Eryk-Mozdzen/minisumo-scalak/README.md

# Autonomous minisumo robot Scalak

<p align="center">
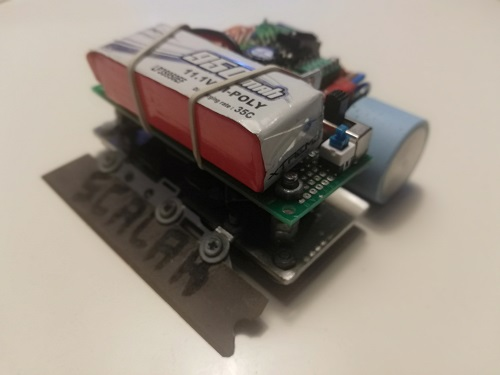
[picture p1: docs/raport/images_overall/scalak_photo1.jpg]
  
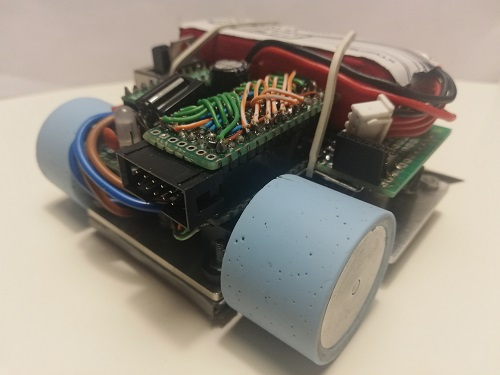
[picture p2: docs/raport/images_overall/scalak_photo2.jpg]
  
</p>

Minisumo robot "Scalak" with ATmega328p microcontroller.
