Eryk-Mozdzen/minisumo-scalak/app/Sumo Remote.png

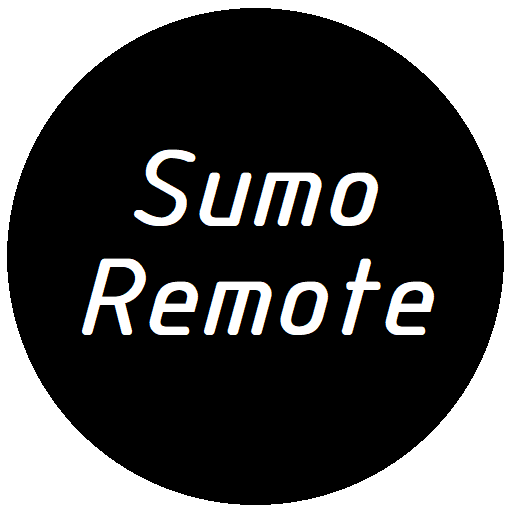
app/Sumo Remote.png
