Eryk-Mozdzen/minisumo-scalak/app/SumoMenagerLayout.png

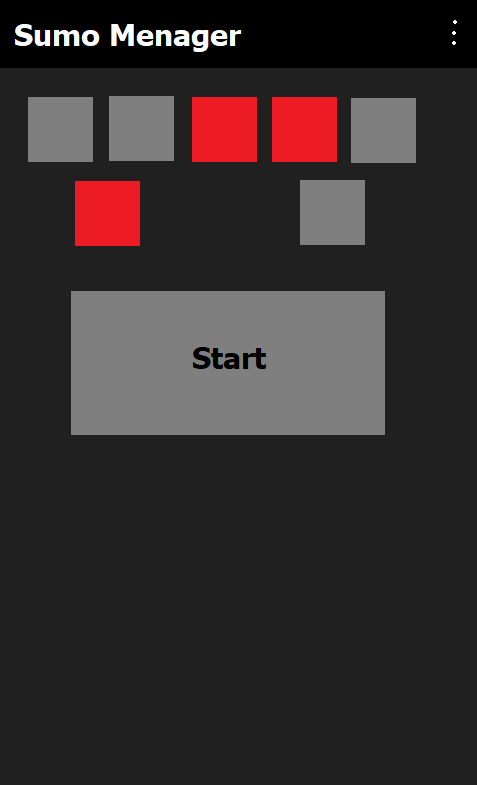
app/SumoMenagerLayout.png
