Eryk-Mozdzen/minisumo-scalak/docs/others/13.jpg

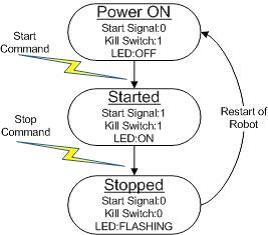
docs/others/13.jpg
