Eryk-Mozdzen/minisumo-scalak/docs/others/ListaDoMiniSumo.png

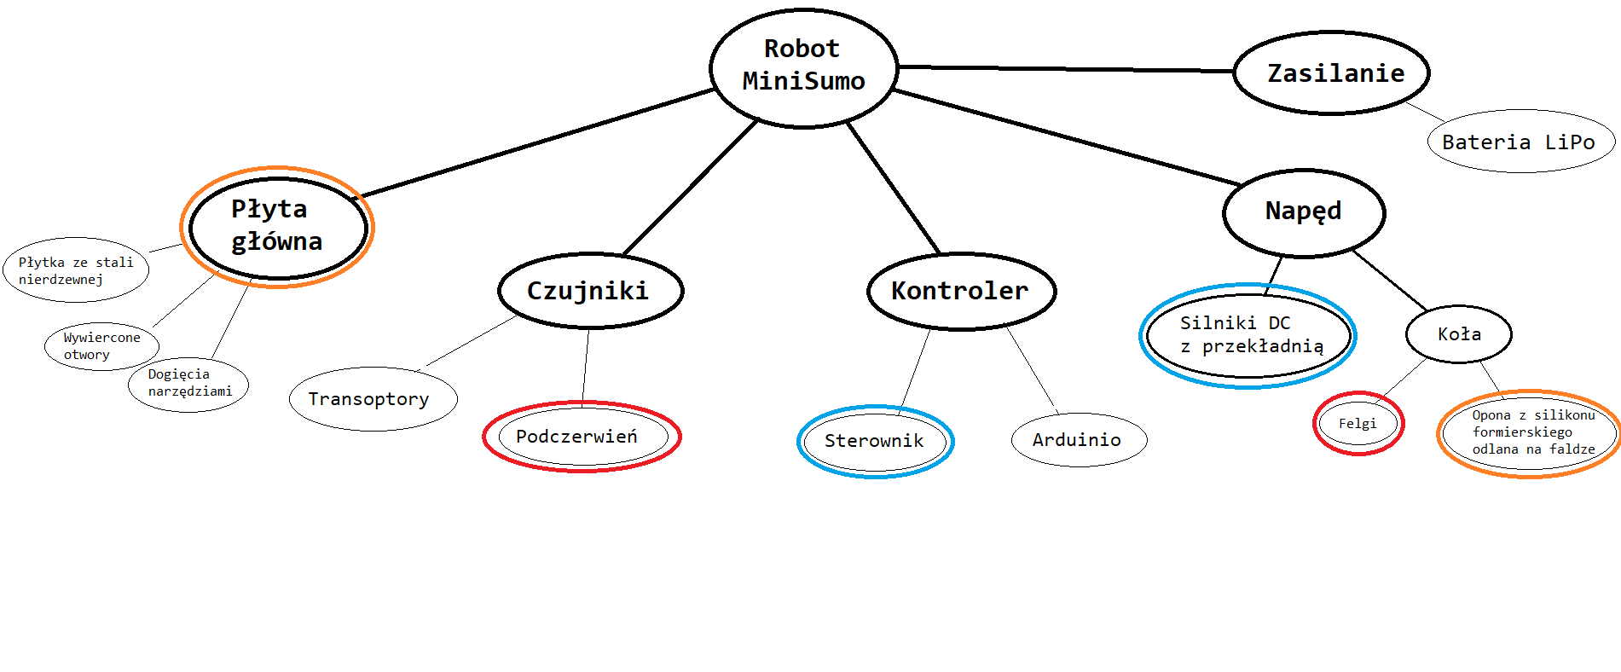
docs/others/ListaDoMiniSumo.png
