Eryk-Mozdzen/minisumo-scalak/docs/others/nazwa.png

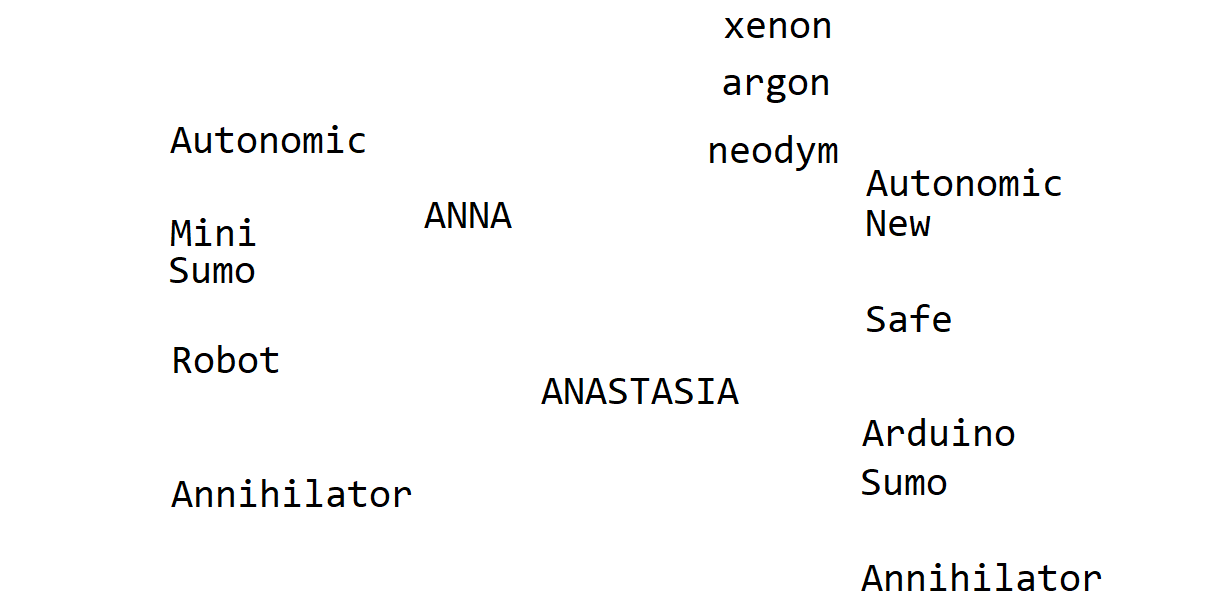
docs/others/nazwa.png
