Eryk-Mozdzen/minisumo-scalak/docs/others/pid_dla_krola.png

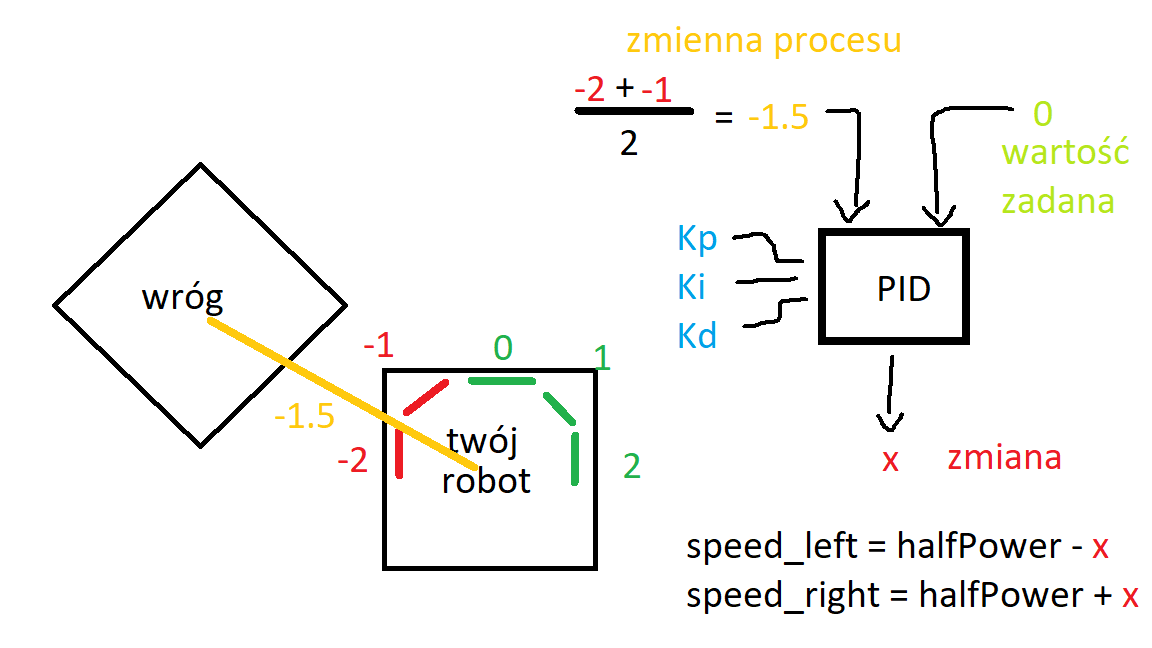
docs/others/pid_dla_krola.png
