Eryk-Mozdzen/minisumo-scalak/docs/others/Przechwytywsefsfeanie.PNG

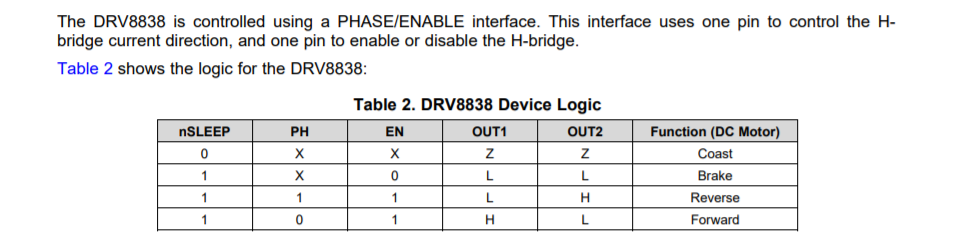
docs/others/Przechwytywsefsfeanie.PNG
