Eryk-Mozdzen/minisumo-scalak/docs/others/rc5_scheme.png

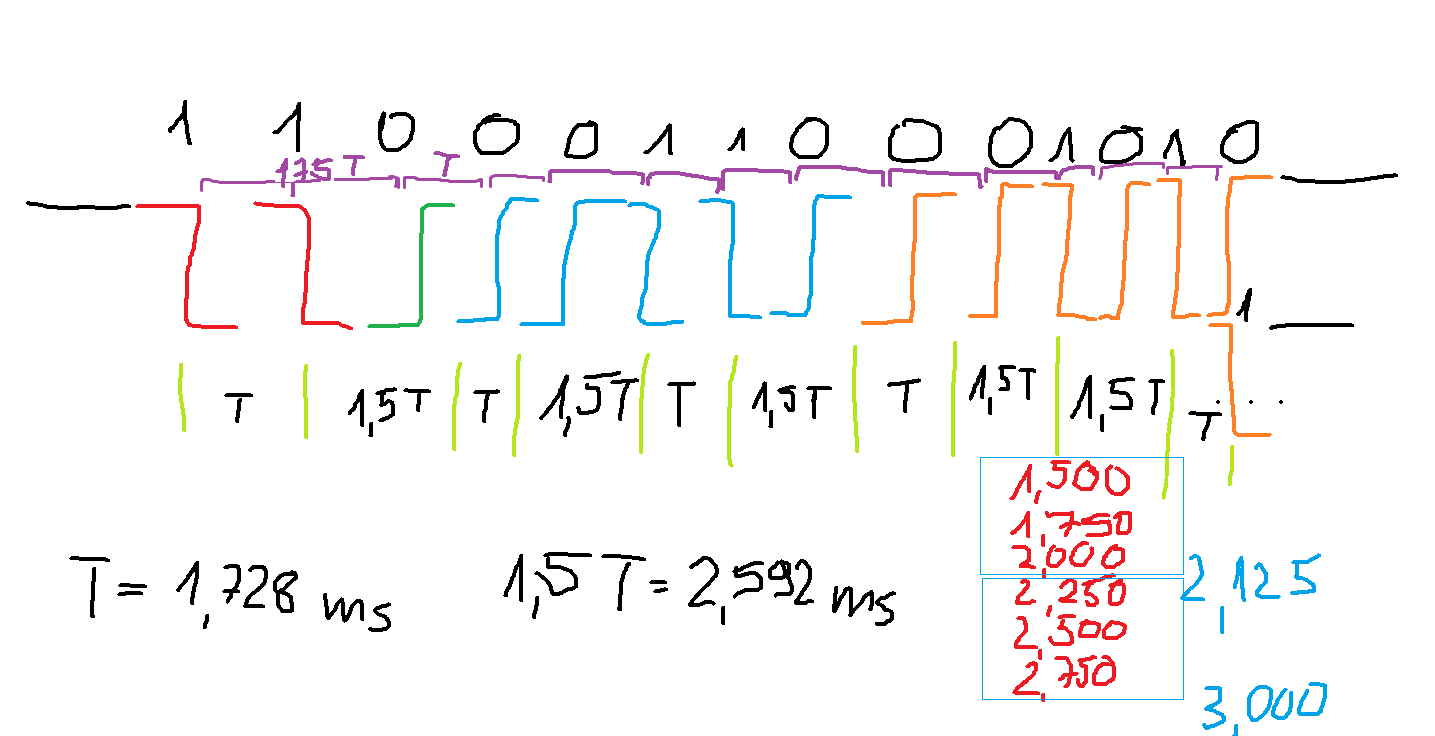
docs/others/rc5_scheme.png
