Eryk-Mozdzen/minisumo-scalak/docs/photos/82588347_592529804923607_3943885901741948928_n.jpg

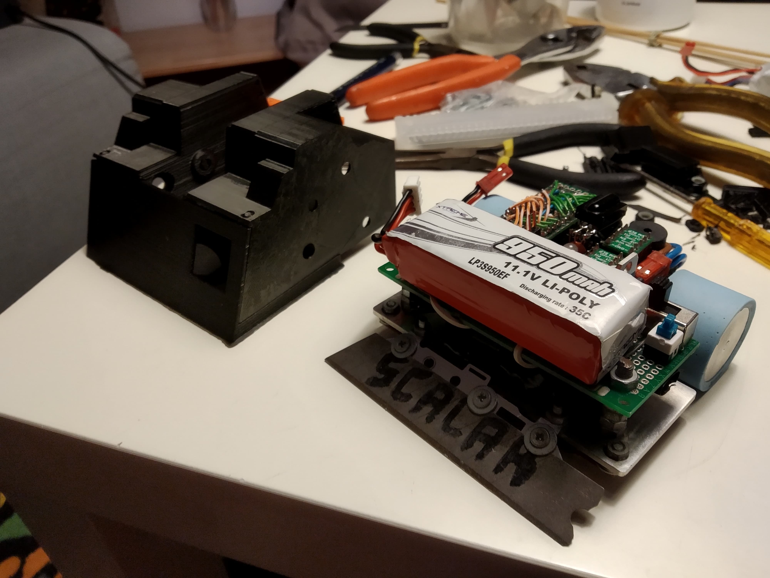
docs/photos/82588347_592529804923607_3943885901741948928_n.jpg
