Eryk-Mozdzen/minisumo-scalak/docs/photos/82605323_181935769839971_6889383114812948480_n.jpg

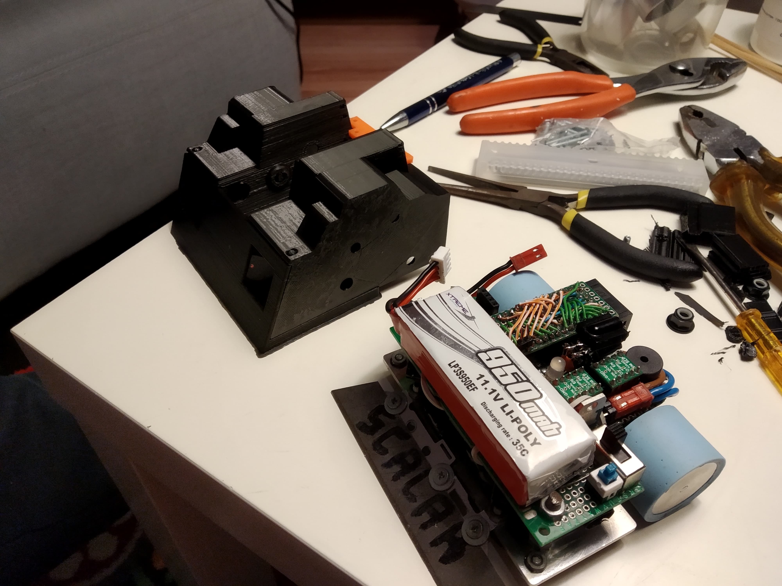
docs/photos/82605323_181935769839971_6889383114812948480_n.jpg
