Eryk-Mozdzen/minisumo-scalak/docs/photos/87043215_3062624950436579_475866983234011136_o.jpg

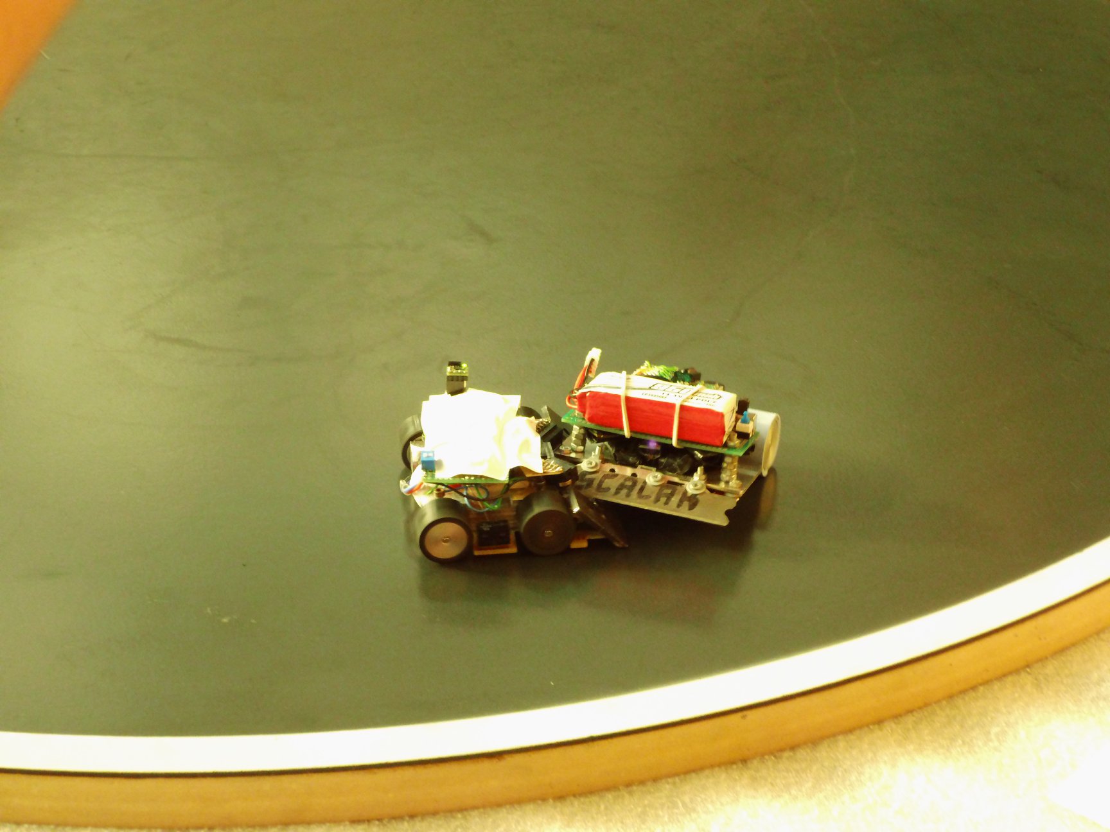
docs/photos/87043215_3062624950436579_475866983234011136_o.jpg
