Eryk-Mozdzen/minisumo-scalak/docs/photos/FB_IMG_1552458001613.jpg

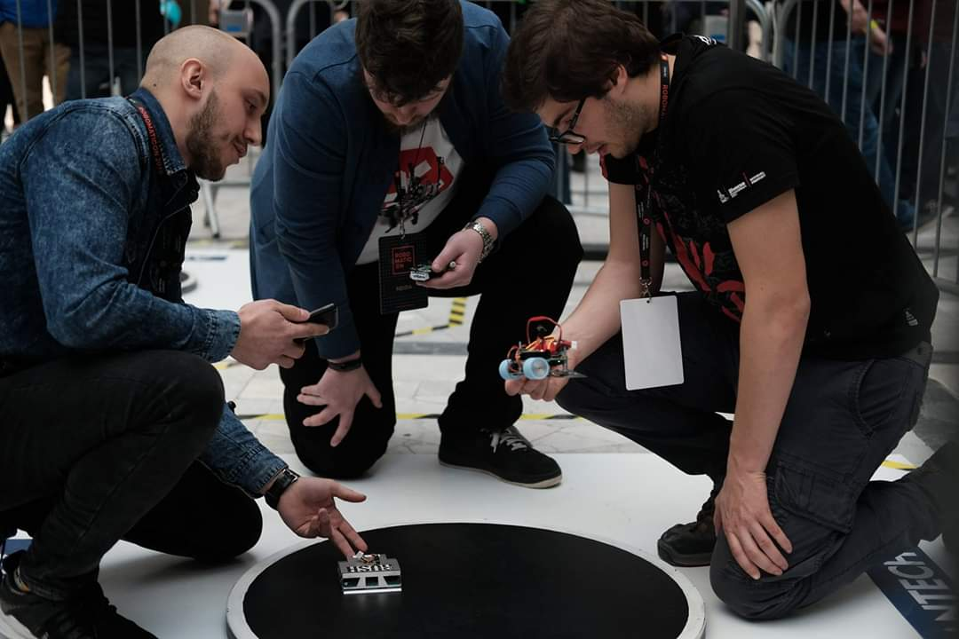
docs/photos/FB_IMG_1552458001613.jpg
