Eryk-Mozdzen/minisumo-scalak/docs/photos/FB_IMG_1580551799463.jpg

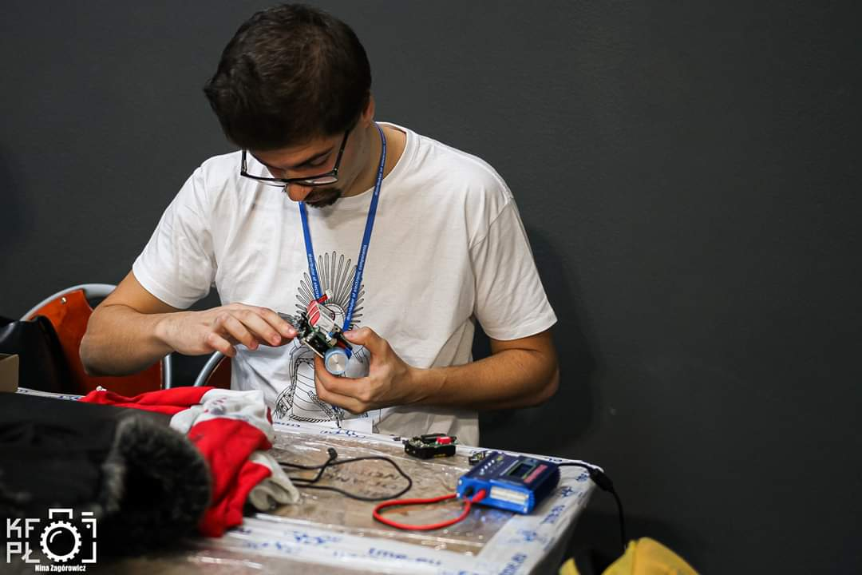
docs/photos/FB_IMG_1580551799463.jpg
