Eryk-Mozdzen/minisumo-scalak/docs/photos/IMG_20200125_100642.jpg

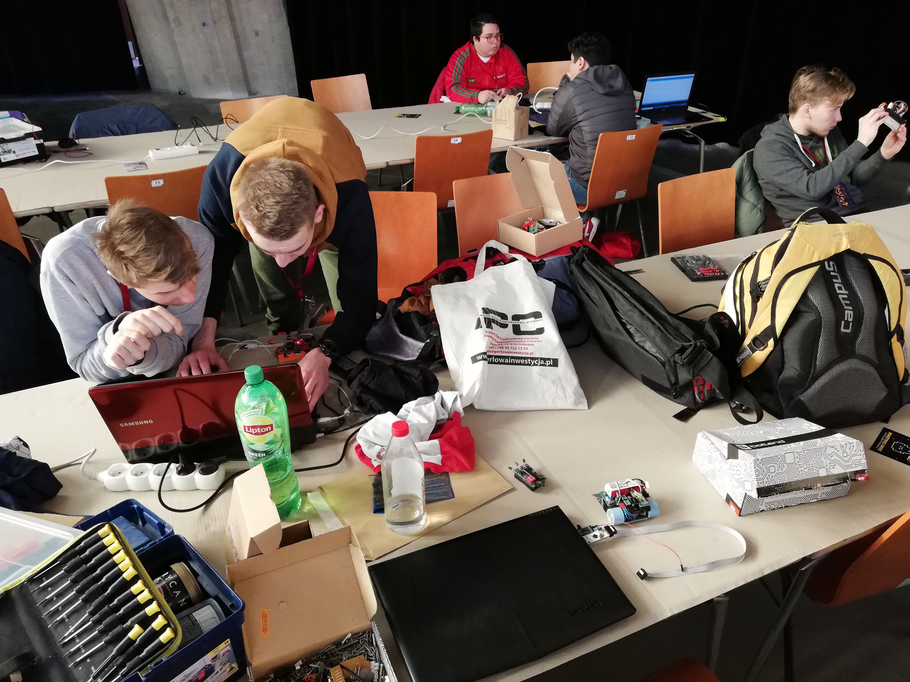
docs/photos/IMG_20200125_100642.jpg
