Eryk-Mozdzen/minisumo-scalak/docs/raport/images_mechanics/scalak_autocad_frame.png

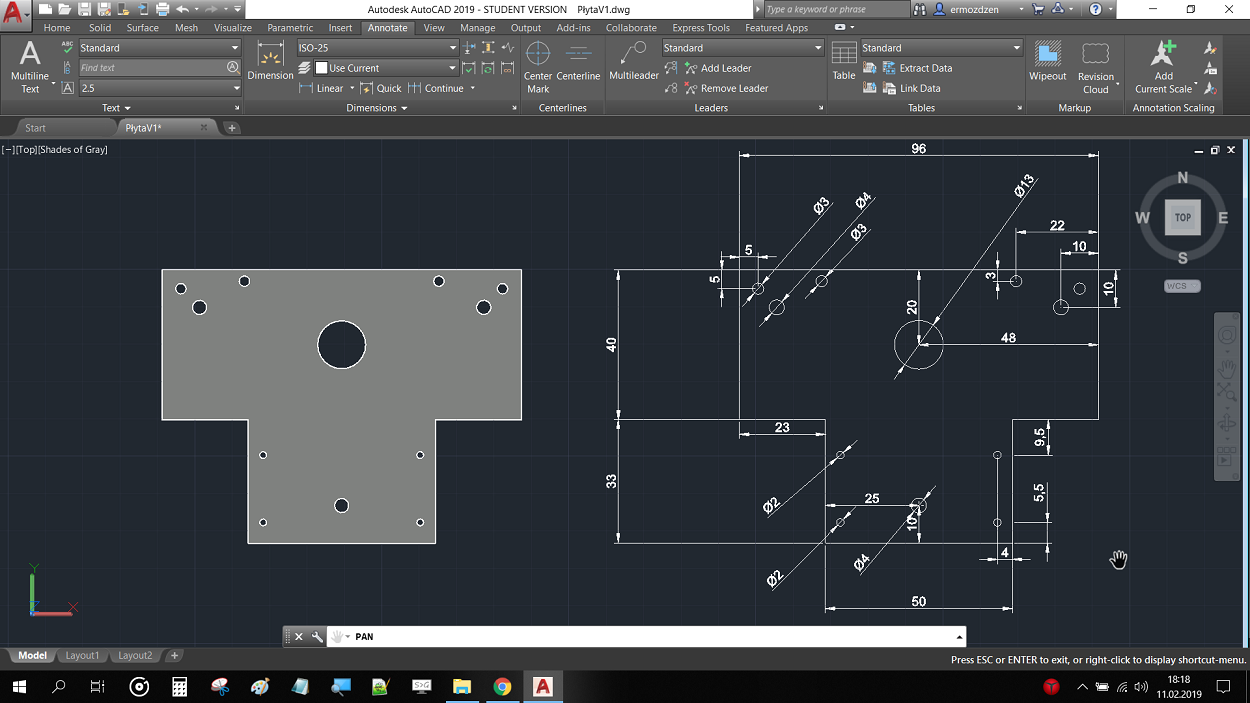
docs/raport/images_mechanics/scalak_autocad_frame.png
