Eryk-Mozdzen/minisumo-scalak/docs/raport/images_mechanics/scalak_autocad_wheel.png

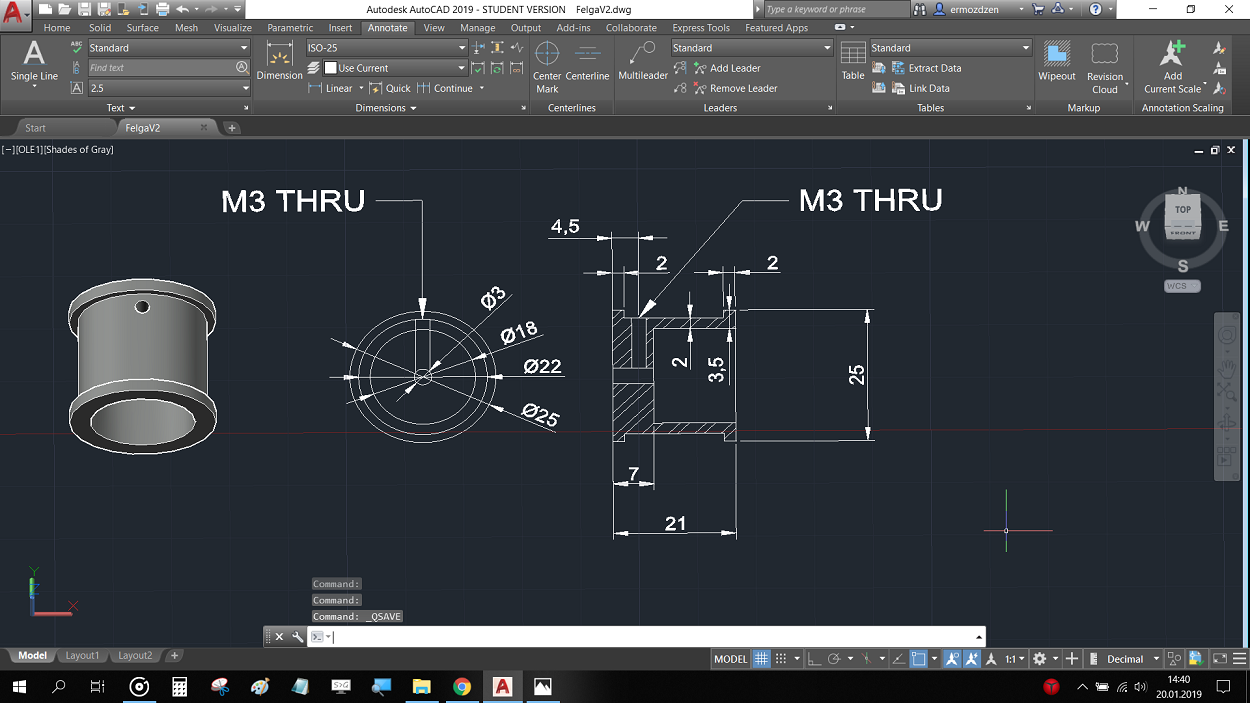
docs/raport/images_mechanics/scalak_autocad_wheel.png
