Eryk-Mozdzen/minisumo-scalak/docs/raport/images_mechanics/scalak_frame1.jpg

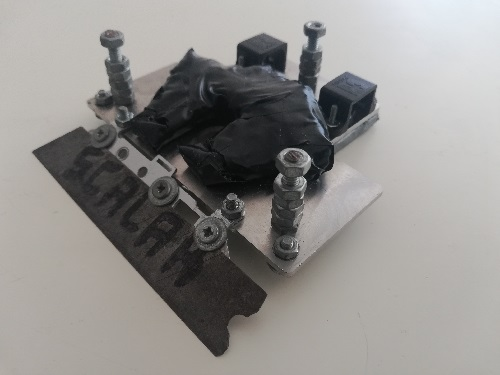
docs/raport/images_mechanics/scalak_frame1.jpg
