Eryk-Mozdzen/minisumo-scalak/docs/raport/images_mechanics/scalak_frame2.jpg

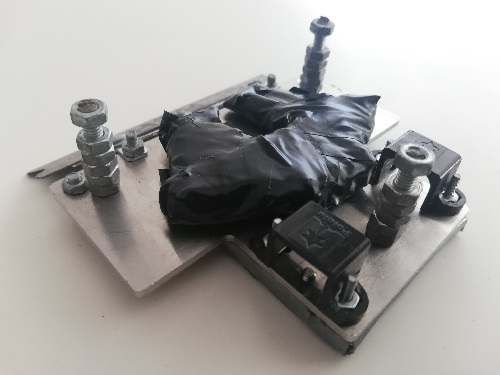
docs/raport/images_mechanics/scalak_frame2.jpg
