Eryk-Mozdzen/minisumo-scalak/docs/raport/images_mechanics/scalak_frame3.jpg

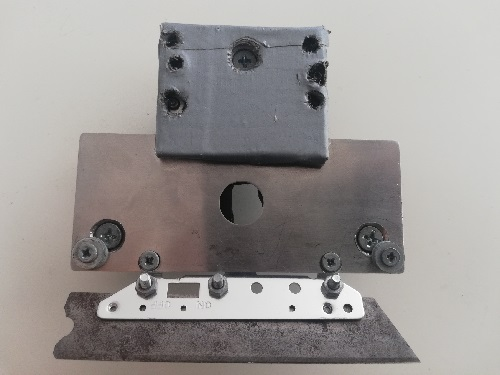
docs/raport/images_mechanics/scalak_frame3.jpg
