Eryk-Mozdzen/minisumo-scalak/docs/raport/images_mechanics/scalak_weight.jpg

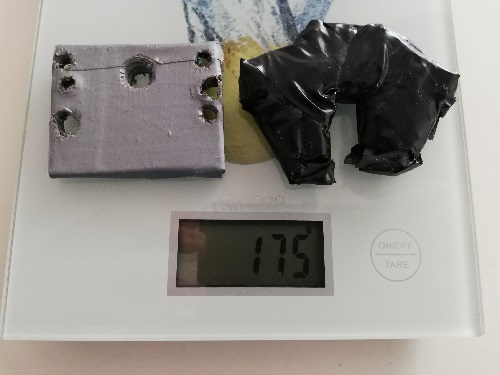
docs/raport/images_mechanics/scalak_weight.jpg
