Eryk-Mozdzen/minisumo-scalak/docs/raport/images_overall/scalak_photo_back.jpg

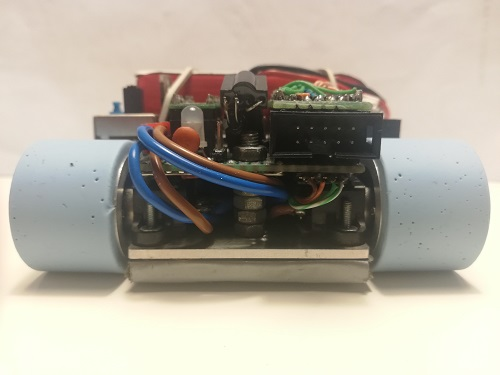
docs/raport/images_overall/scalak_photo_back.jpg
