Eryk-Mozdzen/minisumo-scalak/docs/raport/images_overall/scalak_photo_bottom.jpg

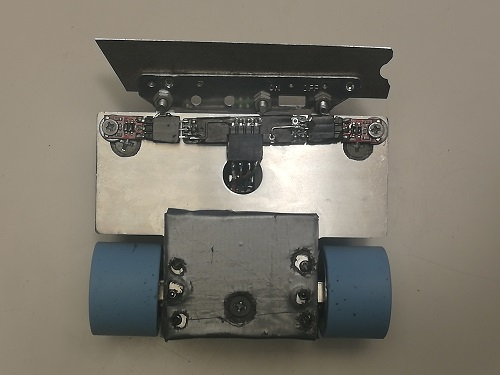
docs/raport/images_overall/scalak_photo_bottom.jpg
