Eryk-Mozdzen/minisumo-scalak/docs/raport/images_overall/scalak_photo_front.jpg

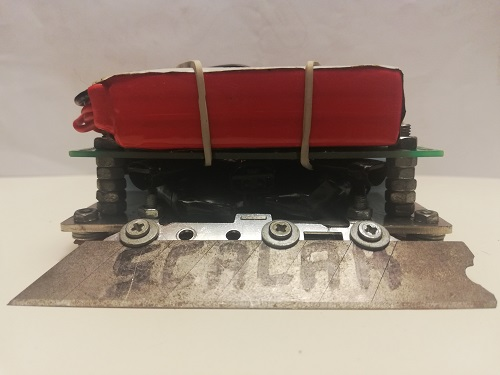
docs/raport/images_overall/scalak_photo_front.jpg
