Eryk-Mozdzen/minisumo-scalak/docs/raport/images_overall/scalak_photo_left.jpg

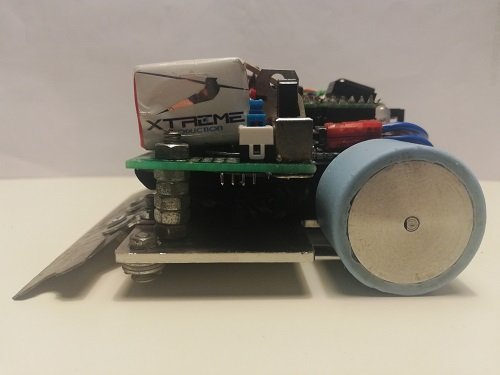
docs/raport/images_overall/scalak_photo_left.jpg
