Eryk-Mozdzen/minisumo-scalak/docs/raport/images_overall/scalak_photo_right.jpg

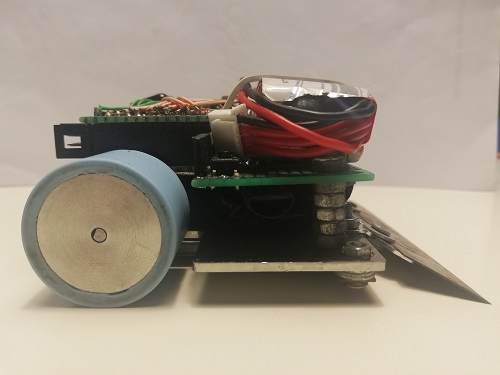
docs/raport/images_overall/scalak_photo_right.jpg
