Eryk-Mozdzen/minisumo-scalak/docs/raport/images_overall/scalak_photo_top.jpg

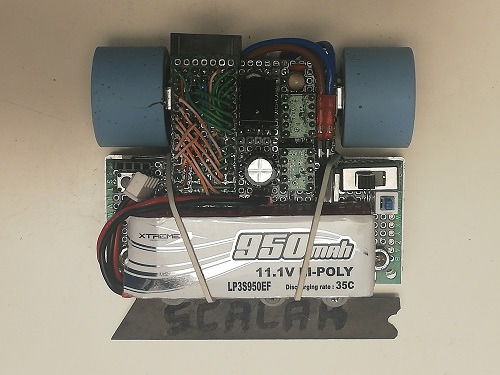
docs/raport/images_overall/scalak_photo_top.jpg
