Eryk-Mozdzen/minisumo-scalak/hardware/notes/DIY_biedaPCB2.png

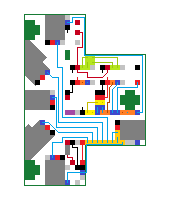
hardware/notes/DIY_biedaPCB2.png
