Eryk-Mozdzen/minisumo-scalak/hardware/notes/DIY_biedaPCB NEW — kopia.png

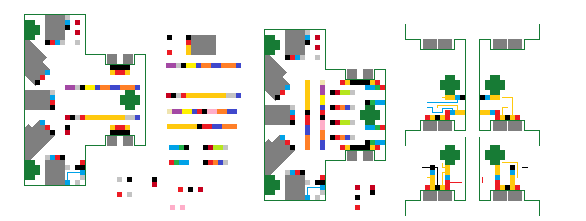
hardware/notes/DIY_biedaPCB NEW — kopia.png
