Eryk-Mozdzen/minisumo-scalak/hardware/notes/DIY_biedaPCB NEW.png

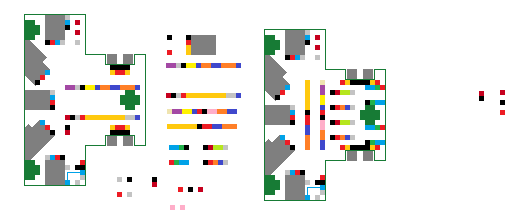
hardware/notes/DIY_biedaPCB NEW.png
