Eryk-Mozdzen/minisumo-scalak/hardware/notes/DIY_biedaPCB.png

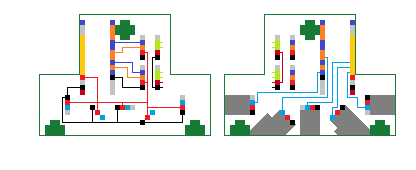
hardware/notes/DIY_biedaPCB.png
