Eryk-Mozdzen/minisumo-scalak/hardware/notes/StartModuleIR.png

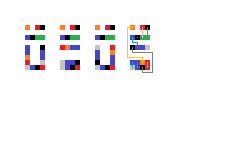
hardware/notes/StartModuleIR.png
