Eryk-Mozdzen/minisumo-scalak/hardware/notes/Zrzut ekranu (163).png

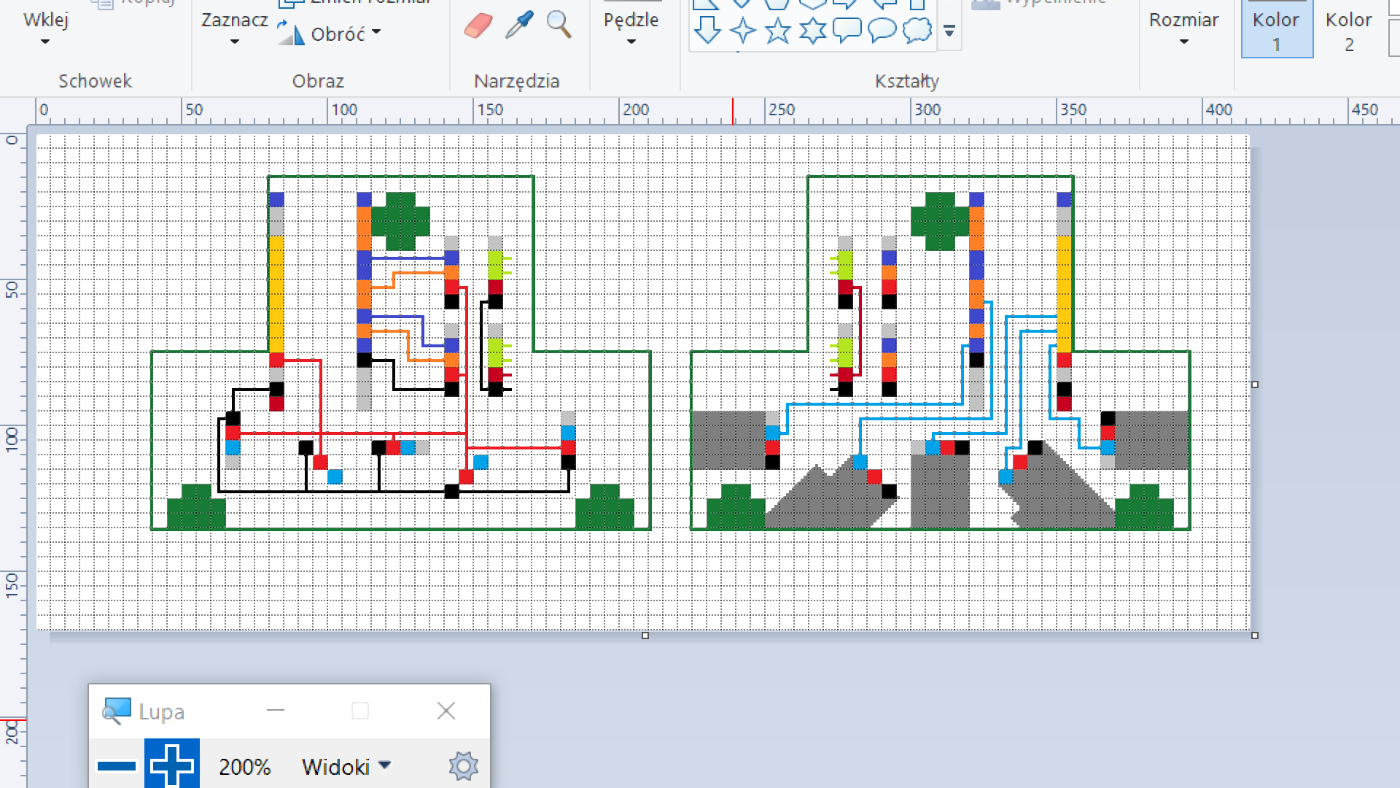
hardware/notes/Zrzut ekranu (163).png
