Eryk-Mozdzen/minisumo-scalak/hardware/pinouts/0J7398.1200.jpg

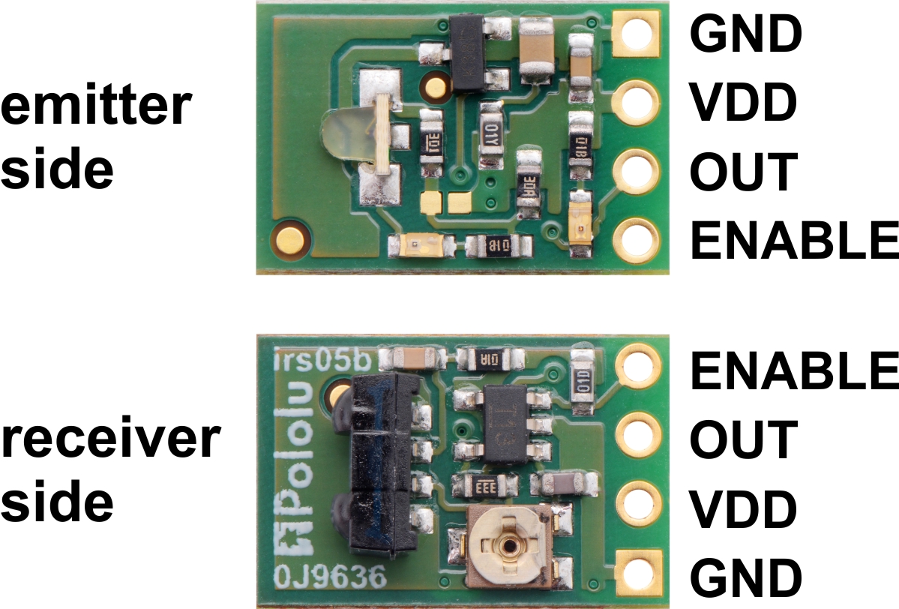
hardware/pinouts/0J7398.1200.jpg
