Eryk-Mozdzen/minisumo-scalak/hardware/pinouts/12.jpg

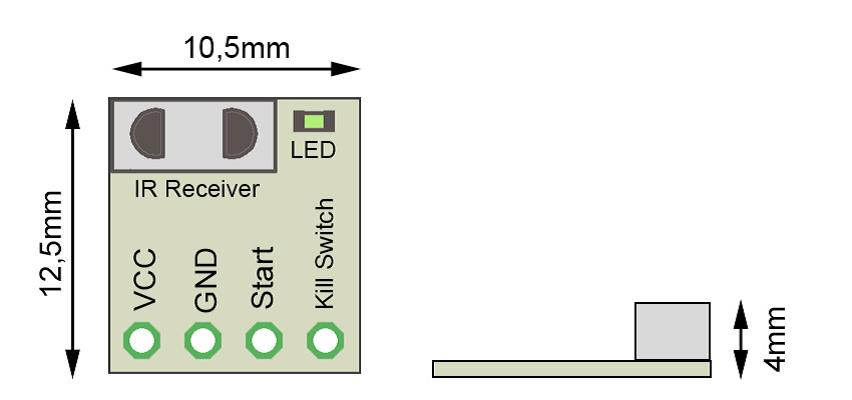
hardware/pinouts/12.jpg
