Eryk-Mozdzen/minisumo-scalak/hardware/pinouts/LM393N_pinout.PNG

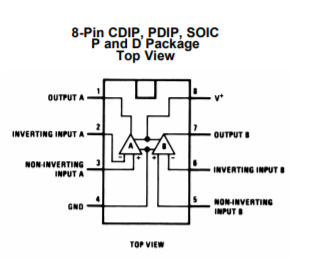
hardware/pinouts/LM393N_pinout.PNG
