Eryk-Mozdzen/minisumo-scalak/hardware/pinouts/Nano_PinOut.png

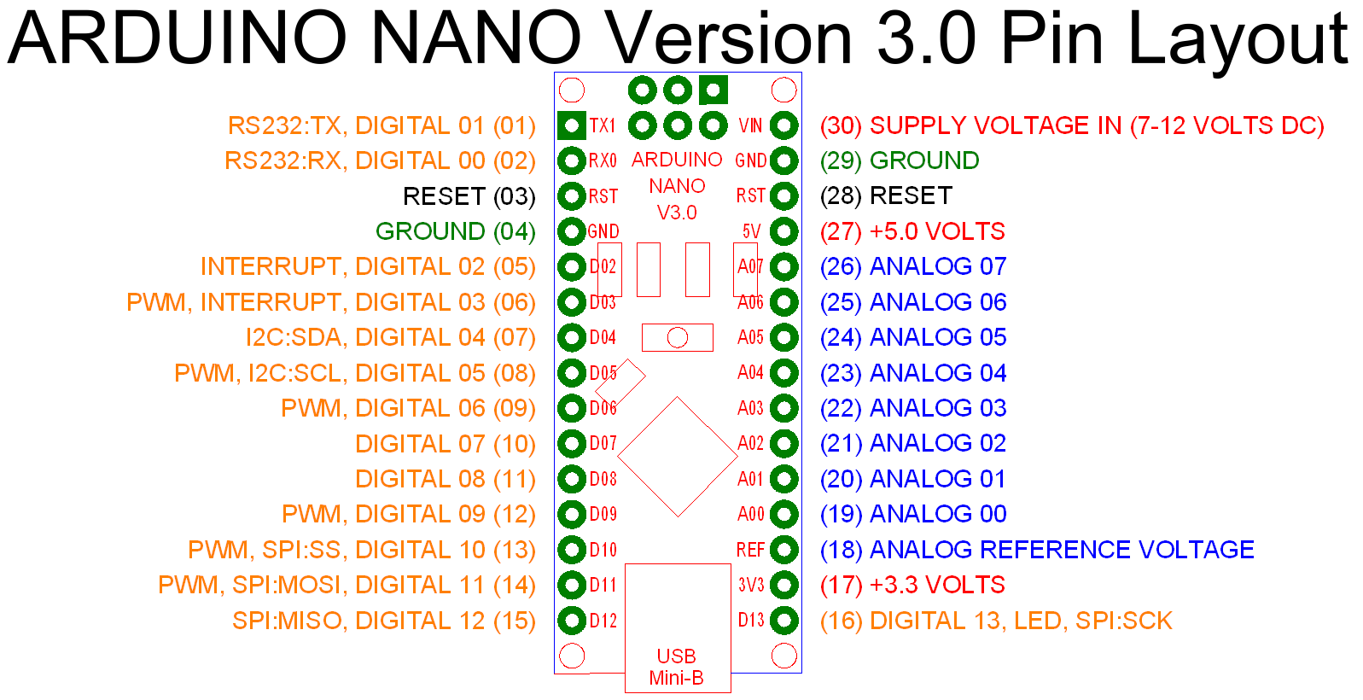
hardware/pinouts/Nano_PinOut.png
