Eryk-Mozdzen/minisumo-scalak/hardware/pinouts/qtr1a.png

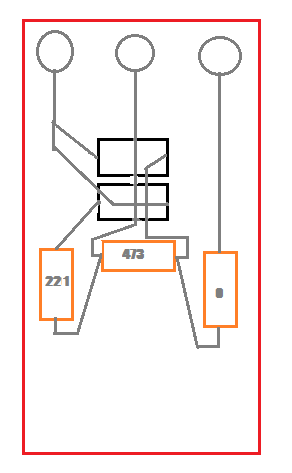
hardware/pinouts/qtr1a.png
