Eryk-Mozdzen/minisumo-scalak/mechanics/04974_5.jpg

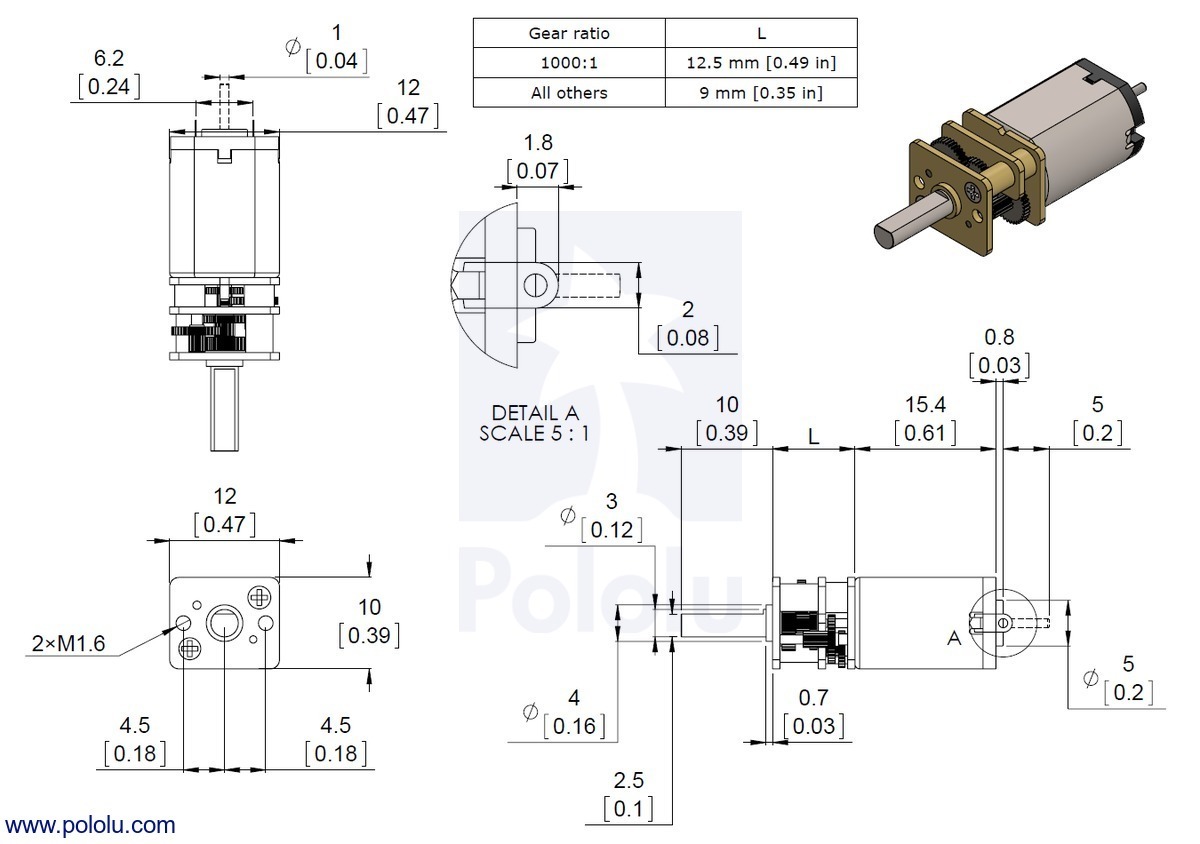
mechanics/04974_5.jpg
