Eryk-Mozdzen/minisumo-scalak/mechanics/60760332_2346503965631605_362769005292814336_n.jpg

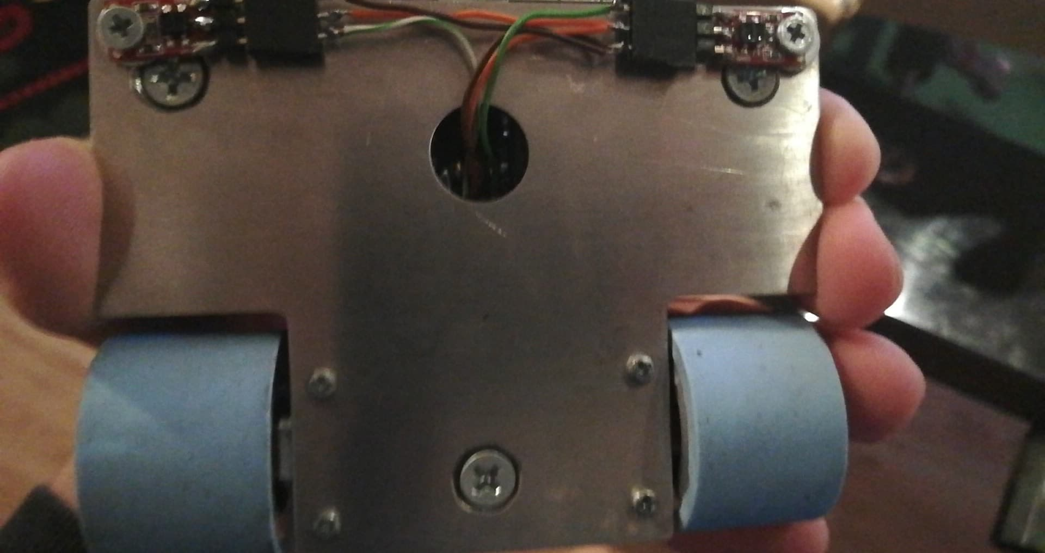
mechanics/60760332_2346503965631605_362769005292814336_n.jpg
