Eryk-Mozdzen/minisumo-scalak/mechanics/Pliki CAD/IR 38 kHz/Horizontal Transmission.jpg

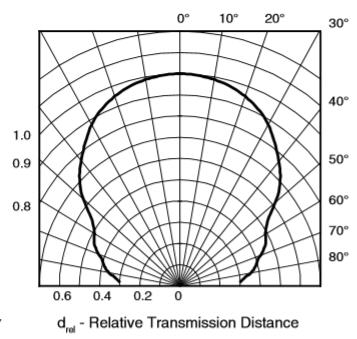
mechanics/Pliki CAD/IR 38 kHz/Horizontal Transmission.jpg
