Eryk-Mozdzen/minisumo-scalak/mechanics/Pliki CAD/IR 38 kHz/Pololu Proximity Render Bottom.JPG

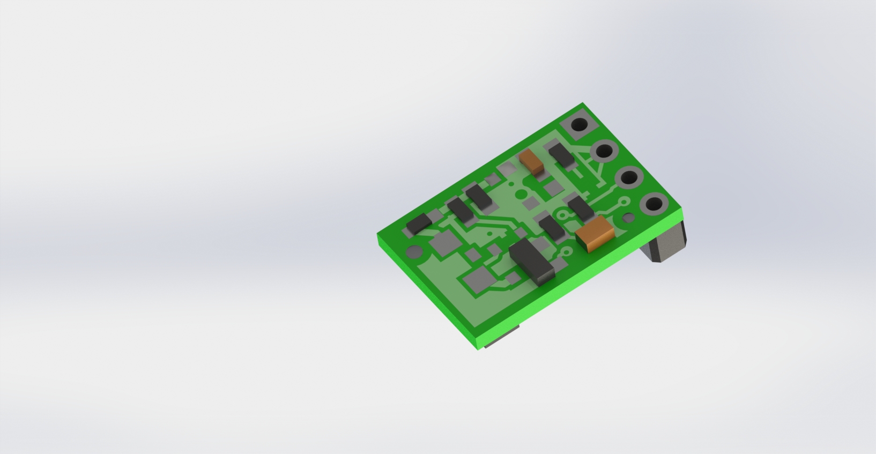
mechanics/Pliki CAD/IR 38 kHz/Pololu Proximity Render Bottom.JPG
