Eryk-Mozdzen/minisumo-scalak/mechanics/Pliki CAD/IR 38 kHz/Pololu Proximity Render.JPG

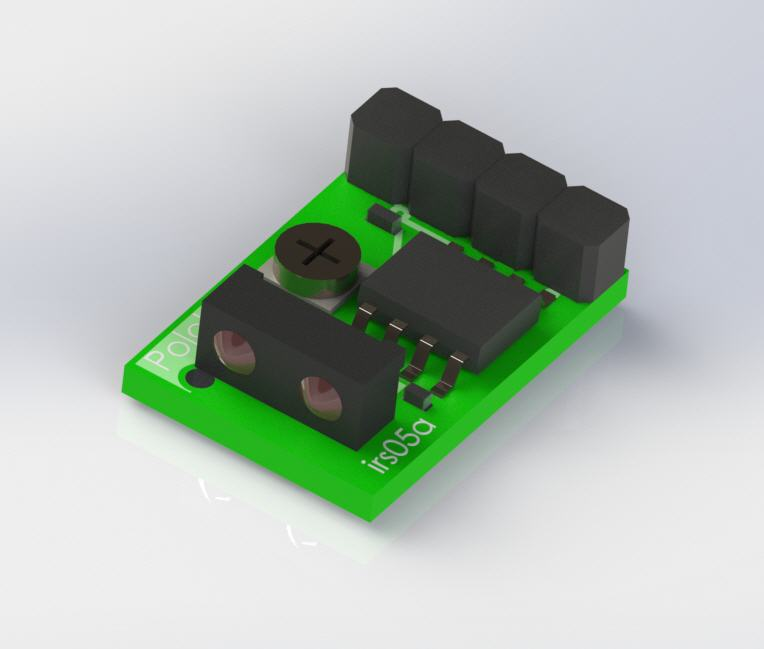
mechanics/Pliki CAD/IR 38 kHz/Pololu Proximity Render.JPG
