Eryk-Mozdzen/minisumo-scalak/mechanics/Pliki CAD/l298n-dc-dual-motor-single-stepper-driver-38mm-centers-1.snapshot.3/2018-11-08_15-25-43.jpg

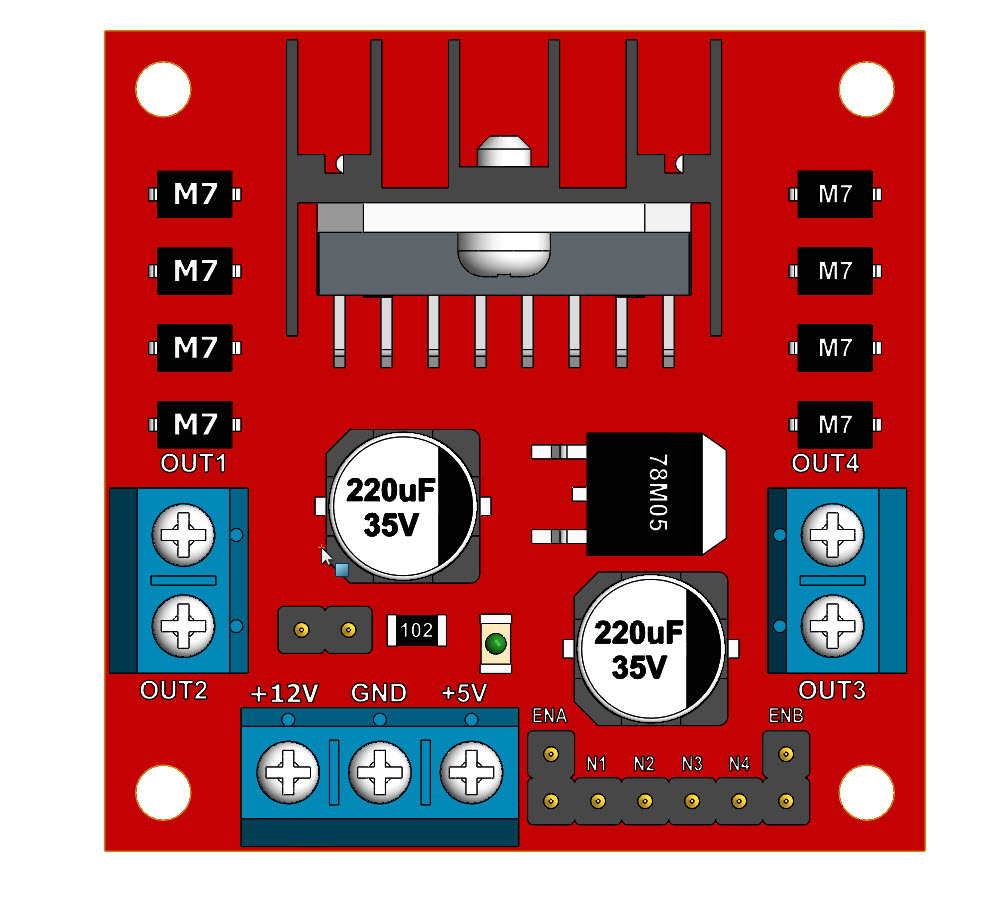
mechanics/Pliki CAD/l298n-dc-dual-motor-single-stepper-driver-38mm-centers-1.snapshot.3/2018-11-08_15-25-43.jpg
