Eryk-Mozdzen/minisumo-scalak/mechanics/Pliki CAD/Pololu Micro Motor  with hub and mounting/Renderings/MicroGearmotor_Pololu_1101.png

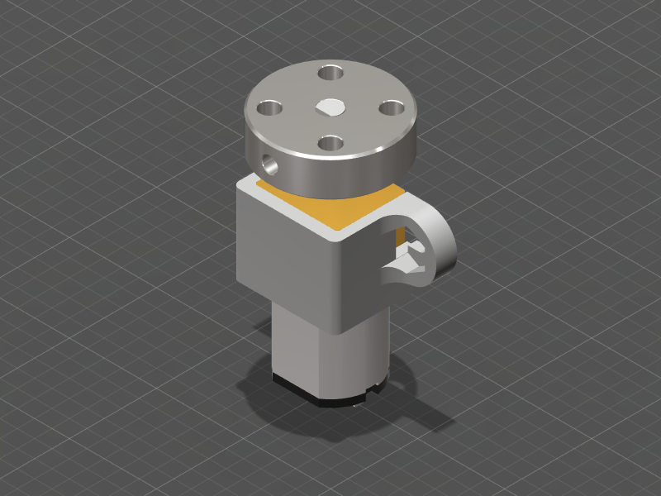
mechanics/Pliki CAD/Pololu Micro Motor with hub and mounting/Renderings/MicroGearmotor_Pololu_1101.png
