Eryk-Mozdzen/minisumo-scalak/software/others/Sterowanie RC/dataWay.png

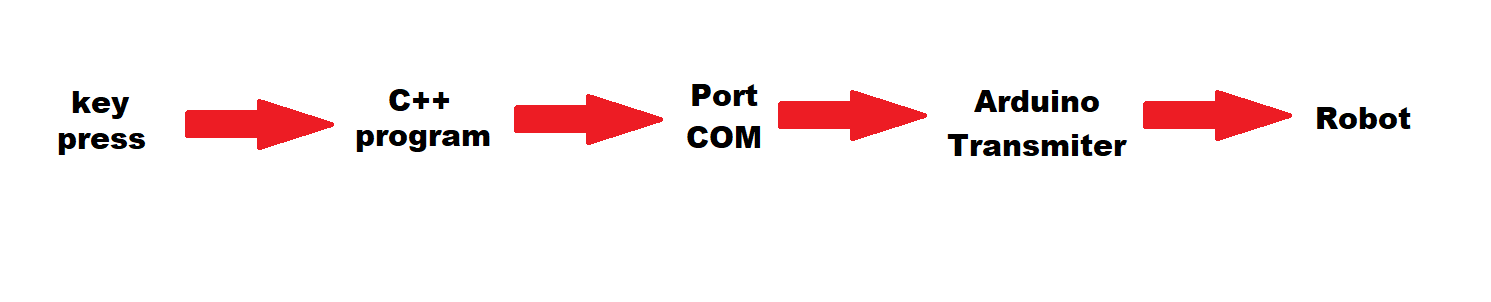
software/others/Sterowanie RC/dataWay.png
