Eryk-Mozdzen/minisumo-scalak/docs/others/components.txt

https://botland.com.pl/pl/sterowniki-silnikow-dc/495-tb6612fng-dwukanalowy-sterownik-silnikow.html

https://botland.com.pl/pl/regulatory-napiecia/471-stabilizator-ldo-33v-lf33cdt-smd-to252.html
https://botland.com.pl/pl/regulatory-napiecia/756-stabilizator-5v-7805-smd-to263.html

https://botland.com.pl/pl/avr-smd/160-mikrokontroler-avr-atmega32a-au-smd.html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

https://botland.com.pl/pl/tact-switch/11104-tact-switch-3x6mm-5mm-smd-5szt.html
https://botland.com.pl/pl/diody-led/1458-zestaw-diod-led-smd-1206-30szt.html

https://botland.com.pl/pl/diody-schottky/250-dioda-schottky-sk23-smd.html

https://www.jacktronic.pl/towar.php?kat=42&katnad=318&art=13099
https://www.jacktronic.pl/towar.php?kat=0&katnad=318&art=14206
https://www.jacktronic.pl/towar.php?kat=0&katnad=318&art=1101
https://www.jacktronic.pl/towar.php?kat=0&katnad=0&art=10358

https://www.jacktronic.pl/towar.php?kat=49&katnad=319&art=14507
https://www.jacktronic.pl/towar.php?kat=0&katnad=319&art=14448
https://www.jacktronic.pl/towar.php?kat=0&katnad=0&art=13179
https://www.jacktronic.pl/towar.php?kat=0&katnad=0&art=11916
