Eryk-Mozdzen/minisumo-scalak/docs/bills/Cennik.xlsx

Nazwa | Cena za sztukę | Ilość | Cena | Waga sztuki | Waga
Silnik + przekładnia | 72.00 zł | 2 | 144.00 zł | 9.5 | 19
Bateria | 40.00 zł | 1 | 40.00 zł | 50 | 50
Kontroler | 14.90 zł | 1 | 14.90 zł | 50 | 50
Sylikon formierski + katalizator | 23.00 zł | 1 | 23.00 zł | 22 | 22
Transoptor | 2.90 zł | 2 | 5.80 zł | 10 | 20
Cyfrowy czujnik odległości | 21.90 zł | 5 | 109.50 zł | 0.6 | 3
Płytka stali nierdzewnej | 5.00 zł | 1 | 5.00 zł | 150 | 150
Felgi (?) |  | 2 | 0.00 zł | 11 | 22
Mocowania do silników | 16.95 zł | 1 | 16.95 zł | 1.4 | 1.4
Hub | 24.90 zł | 1 | 24.90 zł | 20 | 20
 |  |  | 0.00 zł |  | 0
 |  |  | 0.00 zł |  | 0
 |  |  | 0.00 zł |  | 0
Nieprzewidziany bzdety | 50.00 zł | 0 | 0.00 zł | 75 | 0
 |  |  | 0.00 zł |  | 0
 |  |  | 0.00 zł |  | 0
 |  |  | 0.00 zł |  | 0
 |  |  | 0.00 zł |  | 0
 |  |  | 0.00 zł |  | 0
Suma |  |  | 384.05 zł |  | 357.4
