Eryk-Mozdzen/minisumo-scalak/docs/bills/Cennik2.xlsx

Nazwa | Cena za sztukę | Ilość | Cena | Waga sztuki | Waga | Zakupione
Czujnik krawędzi | 16.90 zł | 1 | 16.90 zł | 1 | 1 | x
Cyfrowy czujnik odległości | 21.90 zł | 5 | 109.50 zł | 0.6 | 3 | x
 |  |  | 0.00 zł |  | 0
 |  |  | 0.00 zł |  | 0
 |  |  | 0.00 zł |  | 0
 |  |  | 0.00 zł |  | 0
Płytka stali nierdzewnej | 0.00 zł | 1 | 0.00 zł | 150 | 150
Bateria | 33.00 zł | 1 | 33.00 zł | 50 | 50 | x
 |  |  | 0.00 zł |  | 0
 |  |  | 0.00 zł |  | 0
 |  |  | 0.00 zł |  | 0
Kontroler do silników | 13.90 zł | 2 | 27.80 zł | 1 | 2 | x
 |  |  | 0.00 zł |  | 0
 |  |  | 0.00 zł |  | 0
Sylikon formierski + katalizator | 23.00 zł | 1 | 23.00 zł | 22 | 22 | x
Enkodery | 34.90 zł | 1 | 34.90 zł | 2 | 2 | x
Mocowania do silników | 16.95 zł | 1 | 16.95 zł | 1.4 | 1.4 | x
Silnik + przekładnia | 72.00 zł | 2 | 144.00 zł | 9.5 | 19 | x
Felgi | 25.00 zł | 2 | 50.00 zł | 11 | 22
Suma |  |  | 456.05 zł |  | 272.4
