Eryk-Mozdzen/minisumo-scalak/mechanics/metal_parts/form3.png

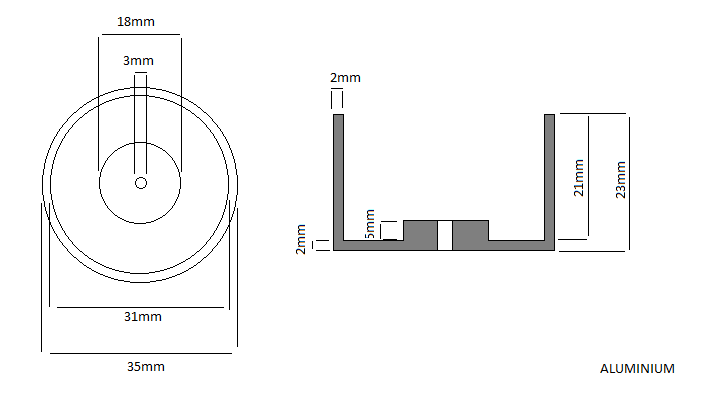
mechanics/metal_parts/form3.png
