Eryk-Mozdzen/minisumo-scalak/mechanics/metal_parts/hubFixed.PNG

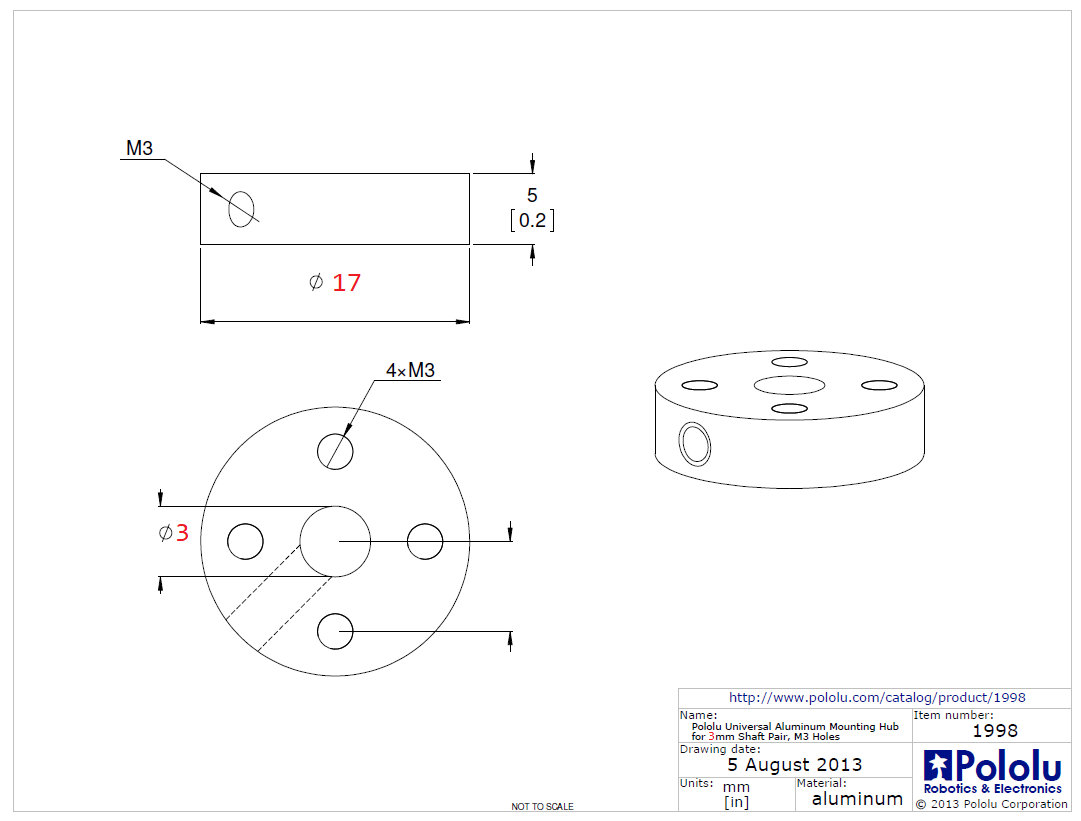
mechanics/metal_parts/hubFixed.PNG
