Eryk-Mozdzen/minisumo-scalak/mechanics/metal_parts/IMG_20190129_194642.jpg

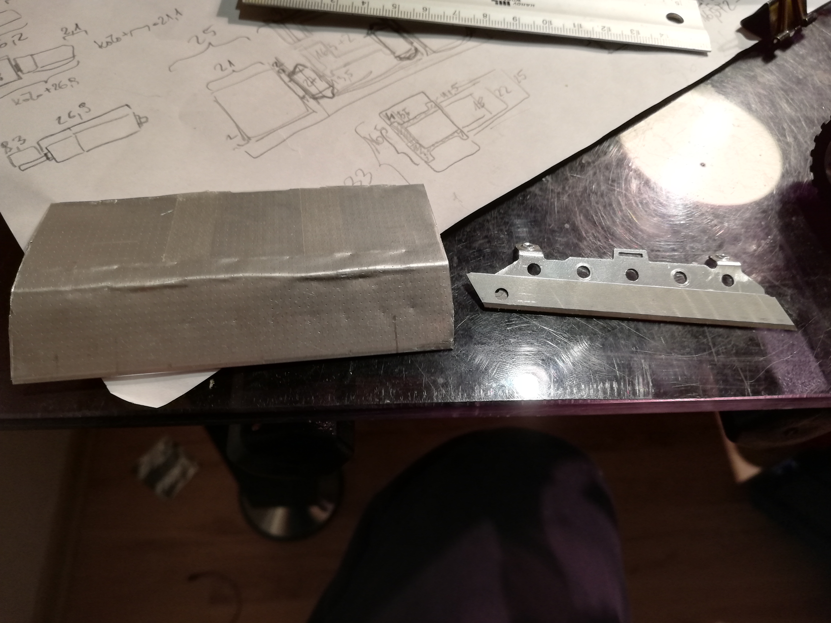
mechanics/metal_parts/IMG_20190129_194642.jpg
