Eryk-Mozdzen/minisumo-scalak/mechanics/metal_parts/IMG_20190301_203751.jpg

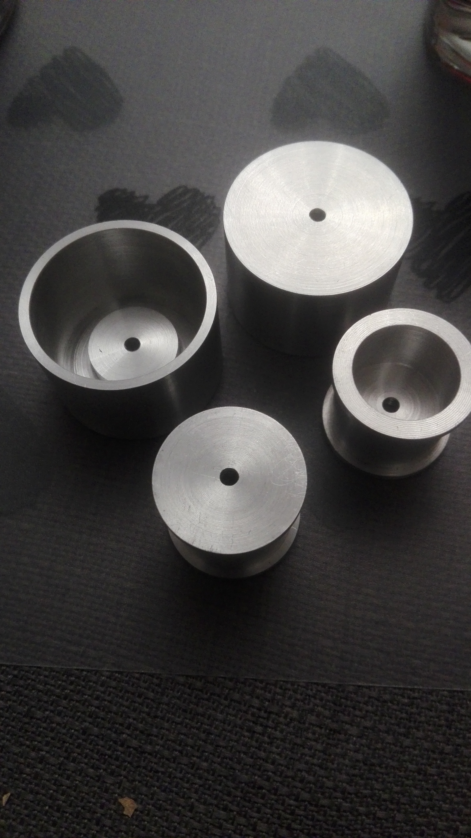
mechanics/metal_parts/IMG_20190301_203751.jpg
