Eryk-Mozdzen/minisumo-scalak/mechanics/metal_parts/JSunoWheels.PNG

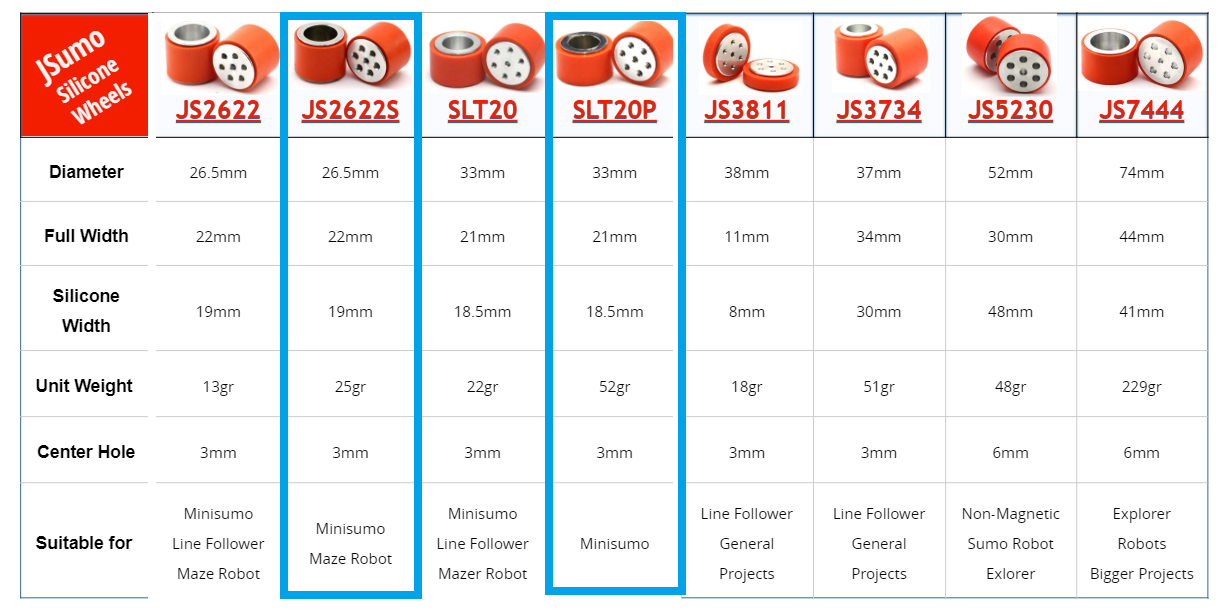
mechanics/metal_parts/JSunoWheels.PNG
