Eryk-Mozdzen/minisumo-scalak/mechanics/metal_parts/WL-JS-3320a-800x800.png

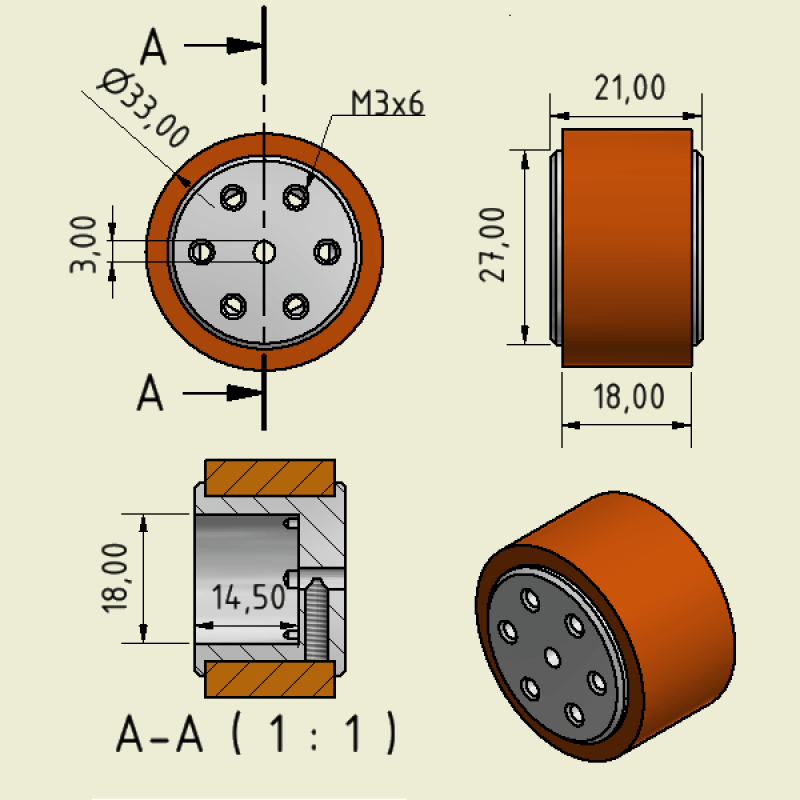
mechanics/metal_parts/WL-JS-3320a-800x800.png
