Eryk-Mozdzen/minisumo-scalak/mechanics/metal_parts/wymiary.jpg.d1e3143ecee42582e4122187f54cc26e.jpg

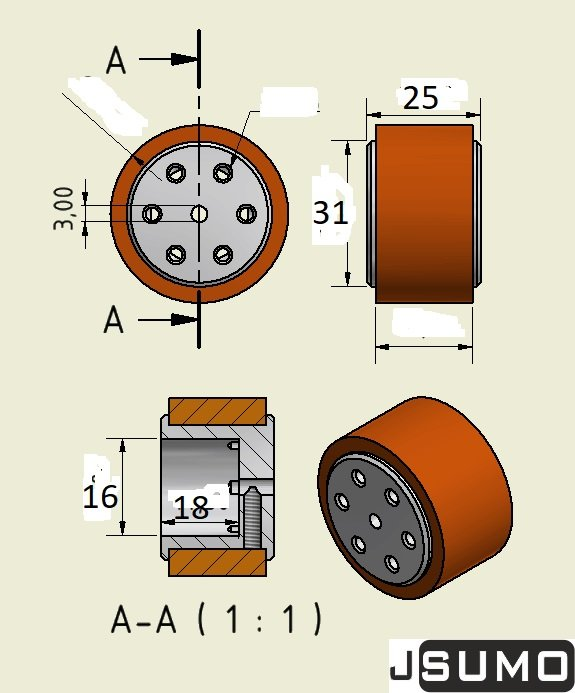
mechanics/metal_parts/wymiary.jpg.d1e3143ecee42582e4122187f54cc26e.jpg
