Eryk-Mozdzen/minisumo-scalak/mechanics/plastic_parts/51635329_320801568565559_2564458121275637760_n.jpg

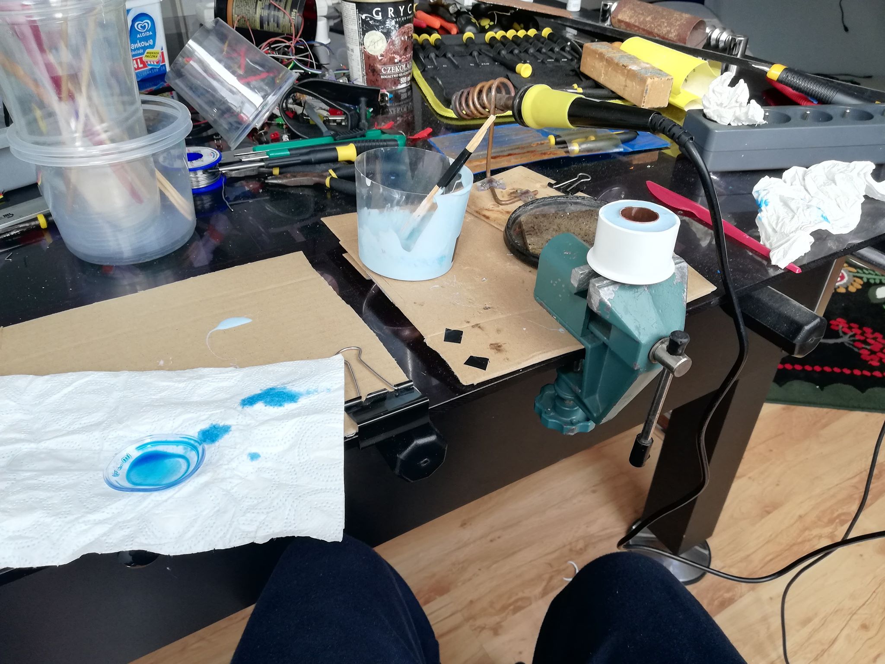
mechanics/plastic_parts/51635329_320801568565559_2564458121275637760_n.jpg
