Eryk-Mozdzen/minisumo-scalak/mechanics/plastic_parts/koło.png

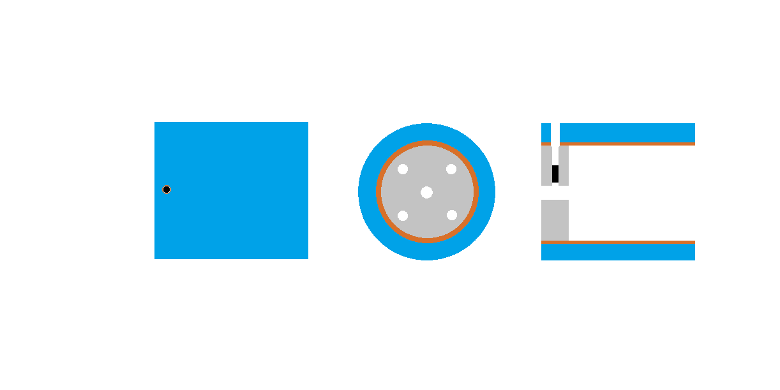
mechanics/plastic_parts/koło.png
