Eryk-Mozdzen/minisumo-scalak/mechanics/plastic_parts/Zrzut ekranu (185).png

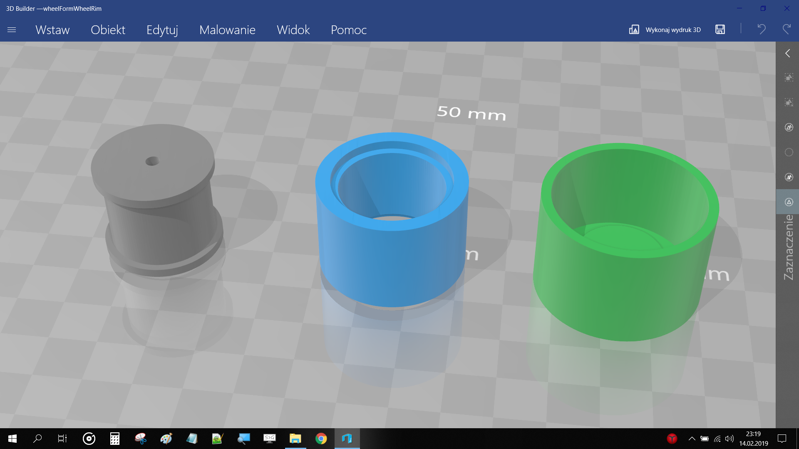
mechanics/plastic_parts/Zrzut ekranu (185).png
