Eryk-Mozdzen/minisumo-scalak/mechanics/plastic_parts/Zrzut ekranu (186).png

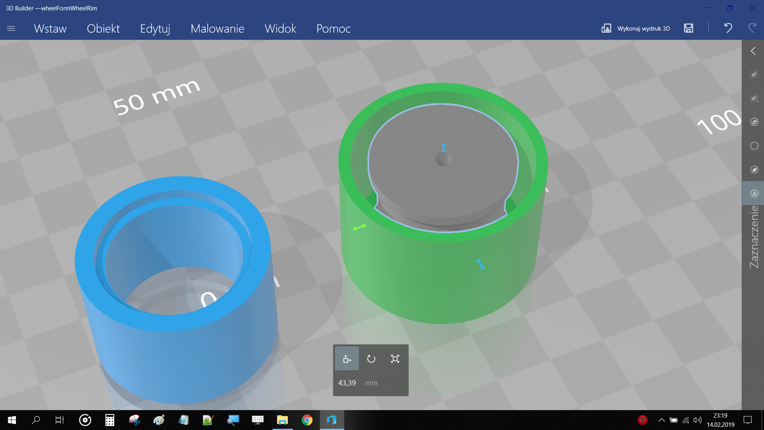
mechanics/plastic_parts/Zrzut ekranu (186).png
