Eryk-Mozdzen/minisumo-scalak/mechanics/plastic_parts/Zrzut ekranu (189).png

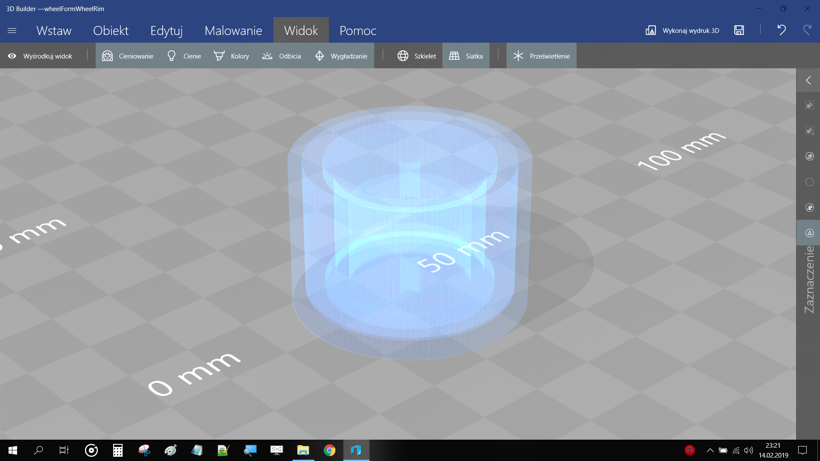
mechanics/plastic_parts/Zrzut ekranu (189).png
