Eryk-Mozdzen/minisumo-scalak/mechanics/Pliki CAD/IR 38 kHz/Proximity Sensor.SLDPRT

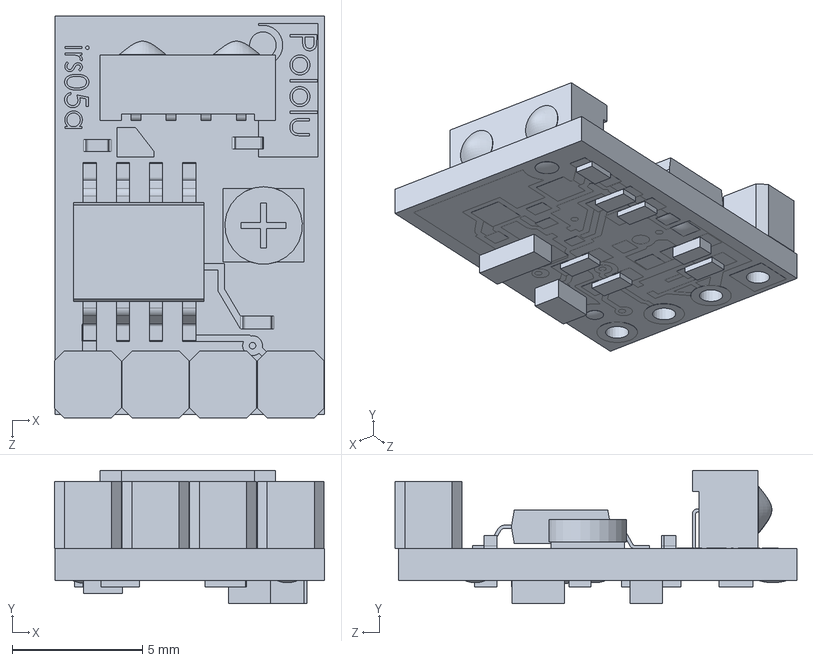
[picture p92: CAD file, 2021-07-06]
mechanics/Pliki CAD/IR 38 kHz/Proximity Sensor.SLDPRT
10.4 x 5.11 x 15.4 mm
