Eryk-Mozdzen/minisumo-scalak/mechanics/Pliki CAD/l298n-driver-1.snapshot.4/L298N Driver/L298N.SLDPRT

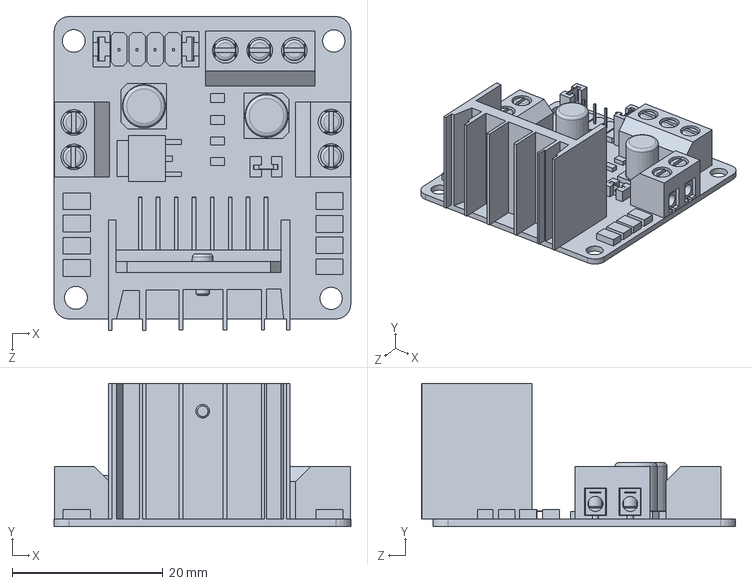
[picture p93: CAD file, 2021-07-06]
mechanics/Pliki CAD/l298n-driver-1.snapshot.4/L298N Driver/L298N.SLDPRT
39.4 x 19.0 x 41.7 mm
