Eryk-Mozdzen/minisumo-scalak/mechanics/Pliki CAD/MiniSumoWheel.IGS

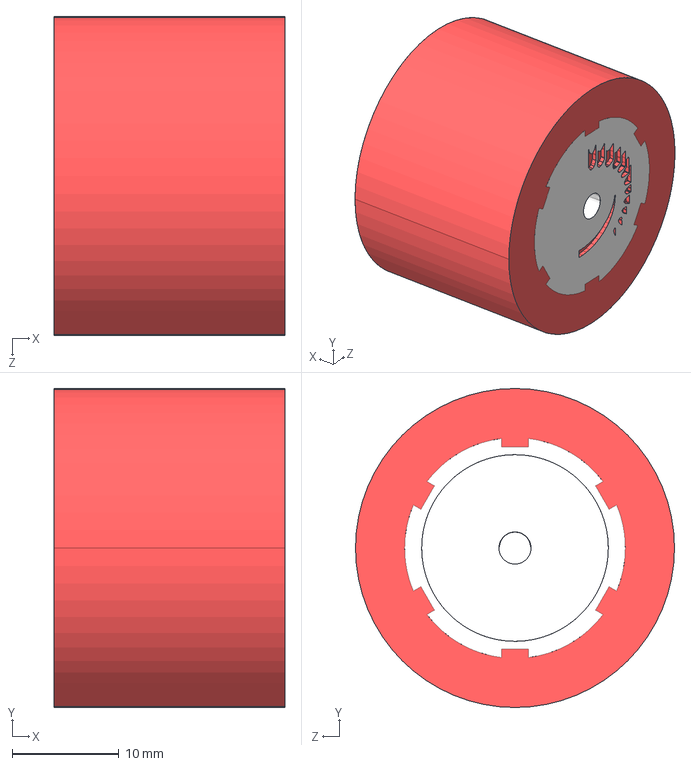
[picture p94: CAD file, 2021-07-06]
mechanics/Pliki CAD/MiniSumoWheel.IGS
21.6 x 29.8 x 29.8 mm
