Eryk-Mozdzen/minisumo-scalak/mechanics/Pliki CAD/Pololu Micro Motor  with hub and mounting/MicroGearmotor_Pololu_1101.igs

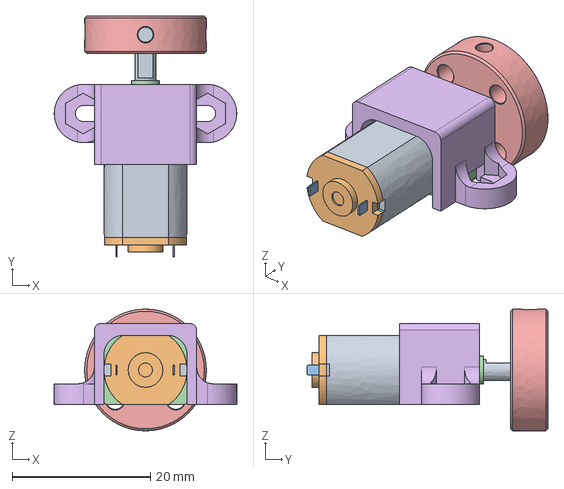
[picture p95: CAD file, 2021-07-06]
mechanics/Pliki CAD/Pololu Micro Motor with hub and mounting/MicroGearmotor_Pololu_1101.igs
26.4 x 34.9 x 17.6 mm
