Eryk-Mozdzen/minisumo-scalak/mechanics/Pliki CAD/Pololu Micro Motor mounting/Bracket.SLDPRT

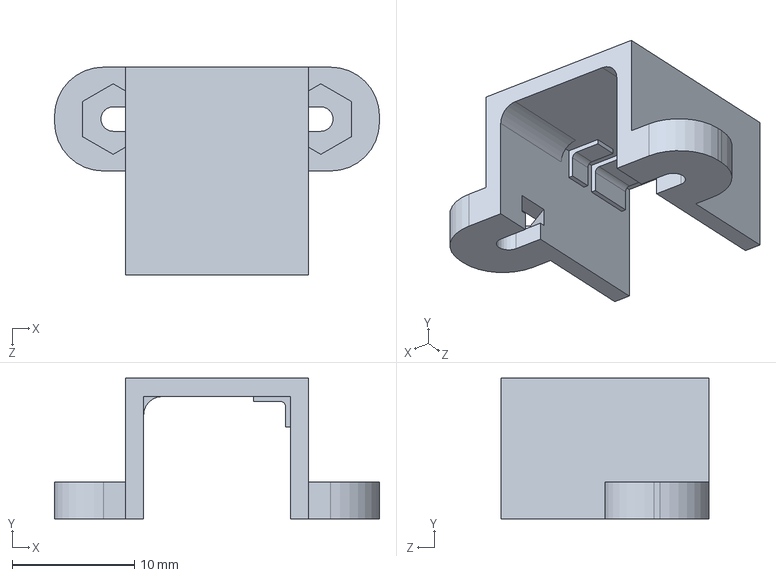
[picture p96: CAD file, 2021-07-06]
mechanics/Pliki CAD/Pololu Micro Motor mounting/Bracket.SLDPRT
26.6 x 11.5 x 17.0 mm
