Eryk-Mozdzen/minisumo-scalak/mechanics/Pliki CAD/Pololu Micro Motor/Pololu #2218 Micro Metal Gearmotor HP.stp

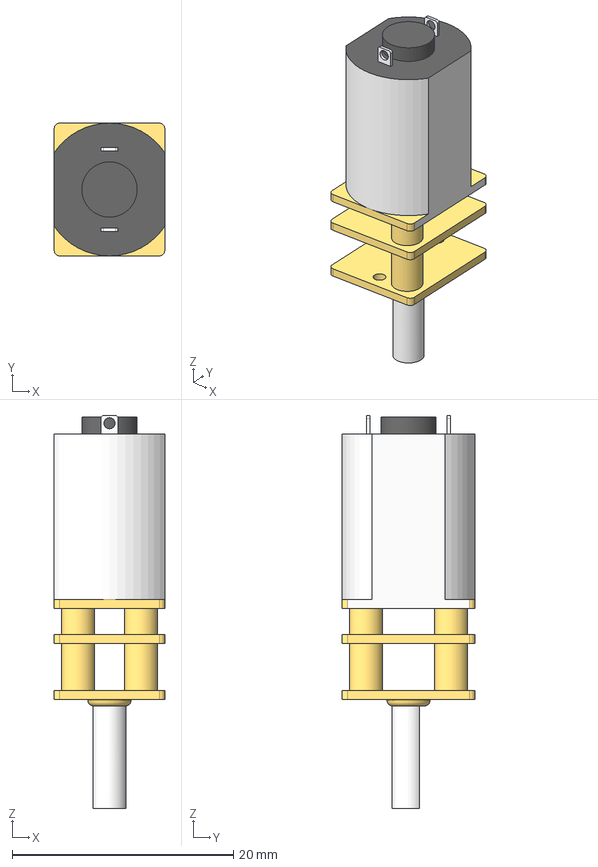
[picture p97: CAD file, 2021-07-06]
mechanics/Pliki CAD/Pololu Micro Motor/Pololu #2218 Micro Metal Gearmotor HP.stp
10.0 x 12.0 x 35.5 mm
