Eryk-Mozdzen/minisumo-scalak/mechanics/Pliki CAD/QTR-1A/qtr-1a-reflectance-sensor.step

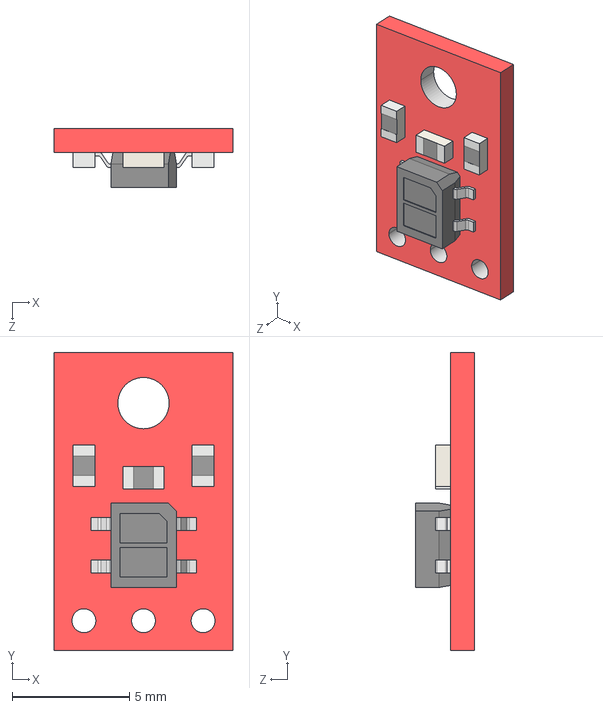
[picture p98: CAD file, 2021-07-06]
mechanics/Pliki CAD/QTR-1A/qtr-1a-reflectance-sensor.step
7.62 x 12.7 x 2.52 mm
