Eryk-Mozdzen/minisumo-scalak/mechanics/plastic_parts/wheelFormWheelRim.3mf

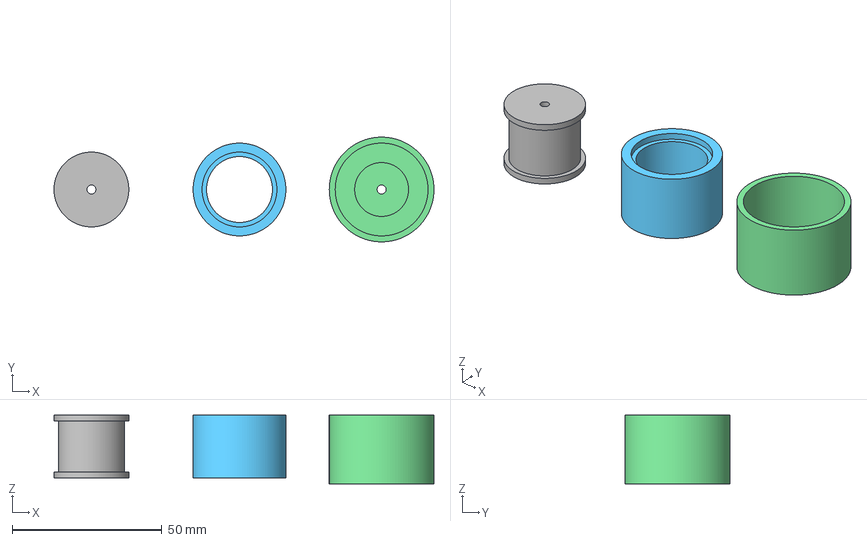
[picture p99: CAD file, 2021-07-06]
mechanics/plastic_parts/wheelFormWheelRim.3mf
127.0 x 35.0 x 23.0 mm
