Eryk-Mozdzen/minisumo-scalak/mechanics/plastic_parts/wheelFormV3.3mf

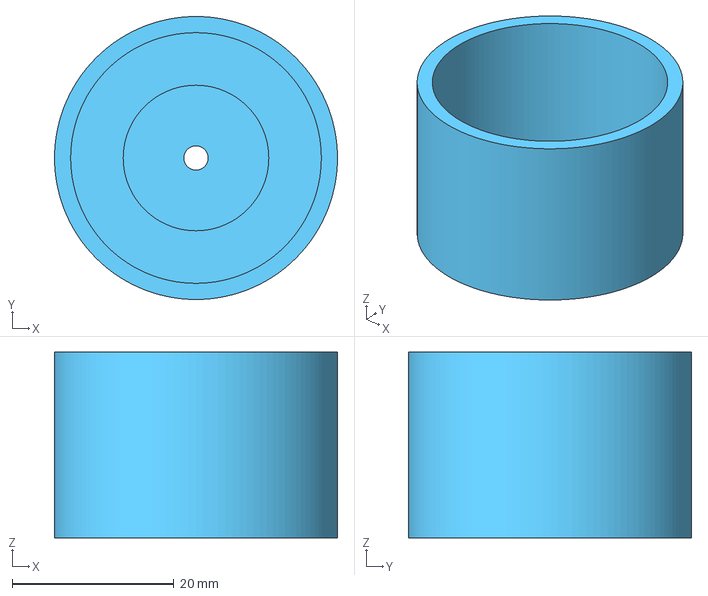
[picture p100: CAD file, 2021-07-06]
mechanics/plastic_parts/wheelFormV3.3mf
35.0 x 35.0 x 23.0 mm
