Eryk-Mozdzen/minisumo-scalak/(list of files, cad)

Other CAD files:
mechanics/SCALAK_nazwa_może_ulec_zmianie.dwg
mechanics/metal_parts/FelgaV2.dwg
mechanics/metal_parts/PłytaV1.dwg
mechanics/metal_parts/FelgaV1.dwg
mechanics/plastic_parts/wheelFormV2.3mf
mechanics/Pliki CAD/IR 38 kHz/Proximity Sensor.IGS
mechanics/Pliki CAD/MR45.x_t
mechanics/Pliki CAD/Pololu Micro Motor with hub and mounting/MicroGearmotor_Pololu_1101.f3d
mechanics/Pliki CAD/Pololu Micro Motor/Pololu #2218 Micro Metal Gearmotor HP.ipt
mechanics/Pliki CAD/QTR-1A/qtr-1a-reflectance-sensor.SLDPRT
