Eryk-Mozdzen/minisumo-scalak/docs/others/modes-of-operation_V0_02.jpg

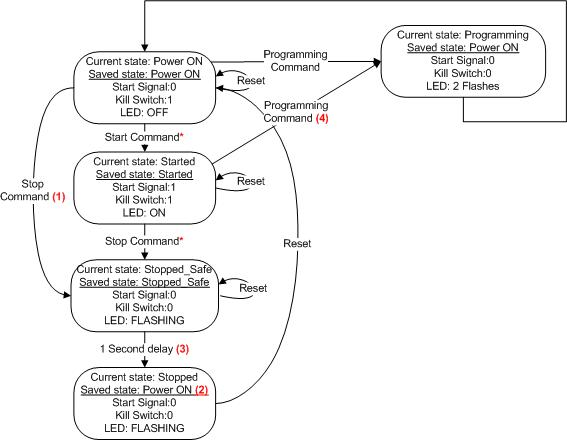
docs/others/modes-of-operation_V0_02.jpg
