Eryk-Mozdzen/minisumo-scalak/docs/raport/images_mechanics/test_wheel1.jpg

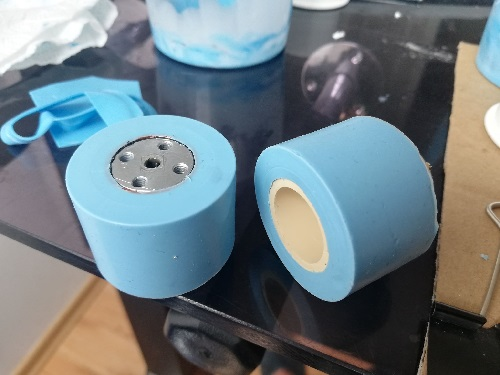
docs/raport/images_mechanics/test_wheel1.jpg
