Eryk-Mozdzen/minisumo-scalak/hardware/scalak_main_board.pdf

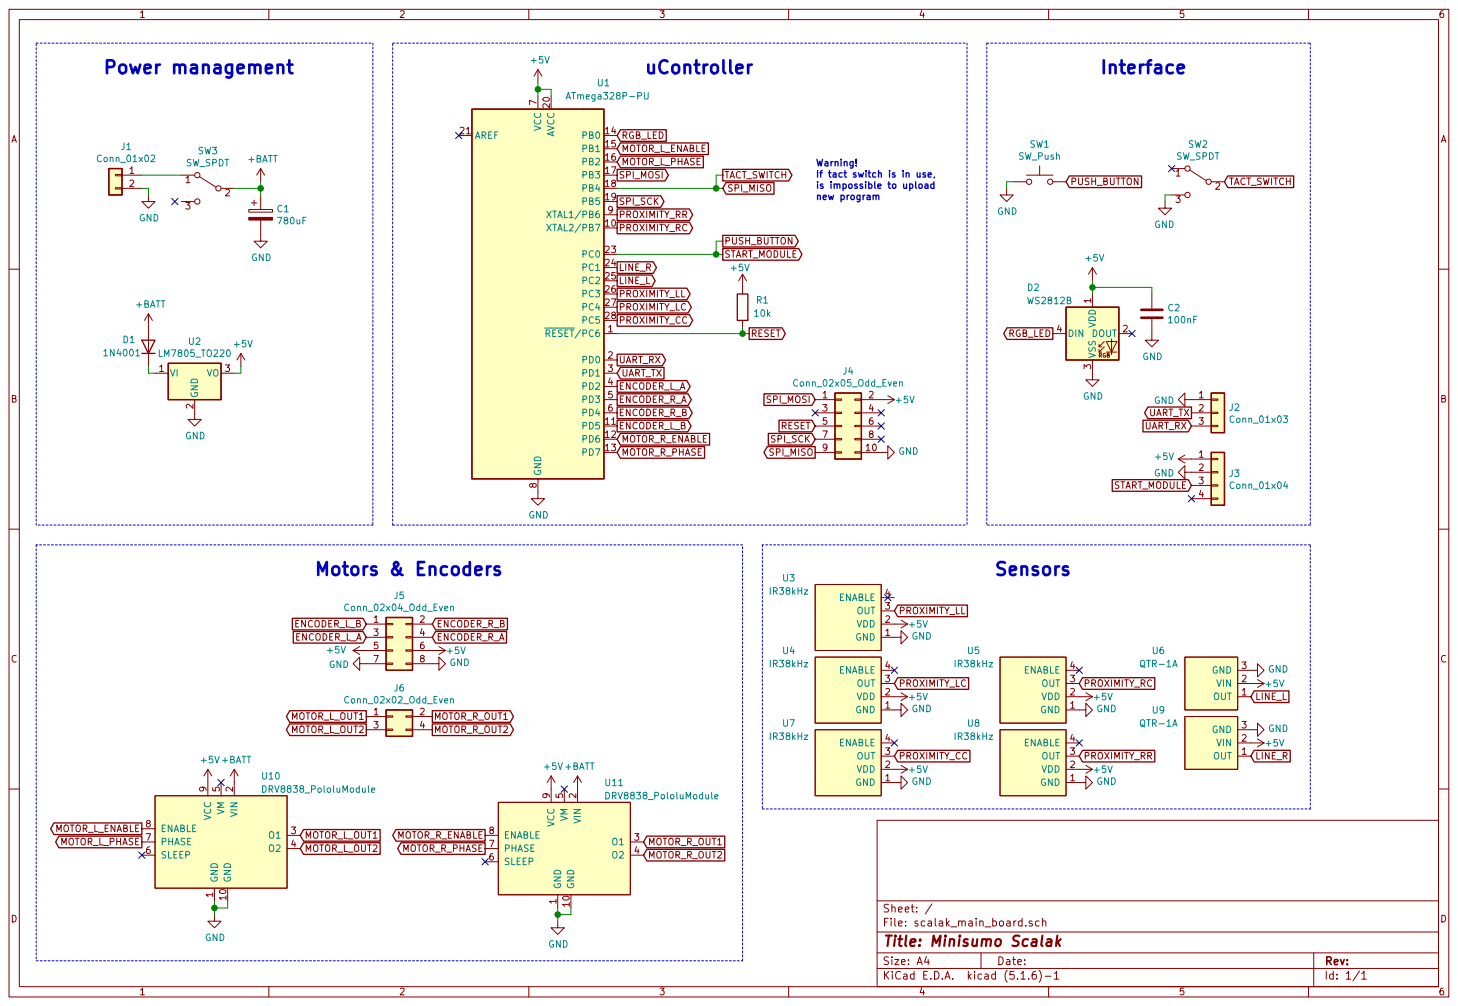
[picture p103: page 1]

Warning!
If tact switch is in use,

3 DIN 4 D2WS2812B GND OUT 1 VIN 2 GND 3 U9 QTR-1A OUT 1 VIN 2 GND 3 U6 QTR-1A GND 1 VDD 2 OUT 3 ENABLE 4 U5

5 SLEEP 6 PHASE 7 ENABLE 8 VCC

File: scalak_main_board.sch Sheet: /
Id: 1/1 Title: Minisumo Scalak
