Eryk-Mozdzen/minisumo-scalak/docs/raport/images_program/minisumo-scalak_program_state_machine_button.pdf

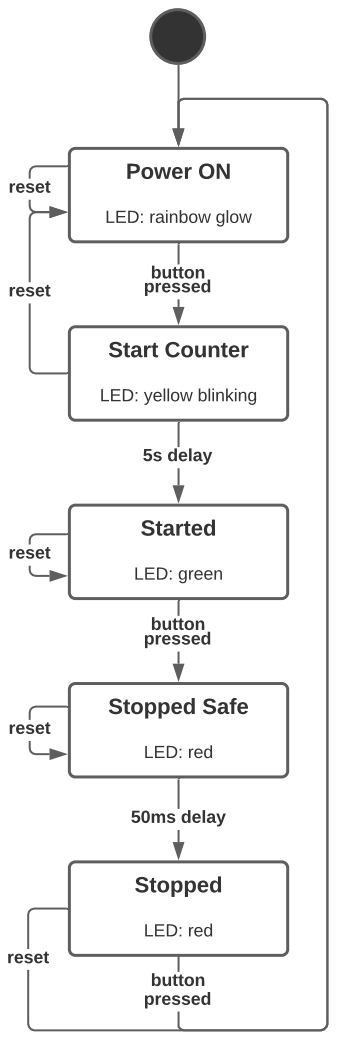
[picture p104: page 1]
Power ON; Started; LED: green; Stopped Safe; LED: red; Stopped; 50ms delay; button pressed; reset; Start Counter; 5s delay

LED: rainbow glow

LED: yellow blinking
