Eryk-Mozdzen/minisumo-scalak/docs/raport/images_program/minisumo-scalak_program_state_machine_module.pdf

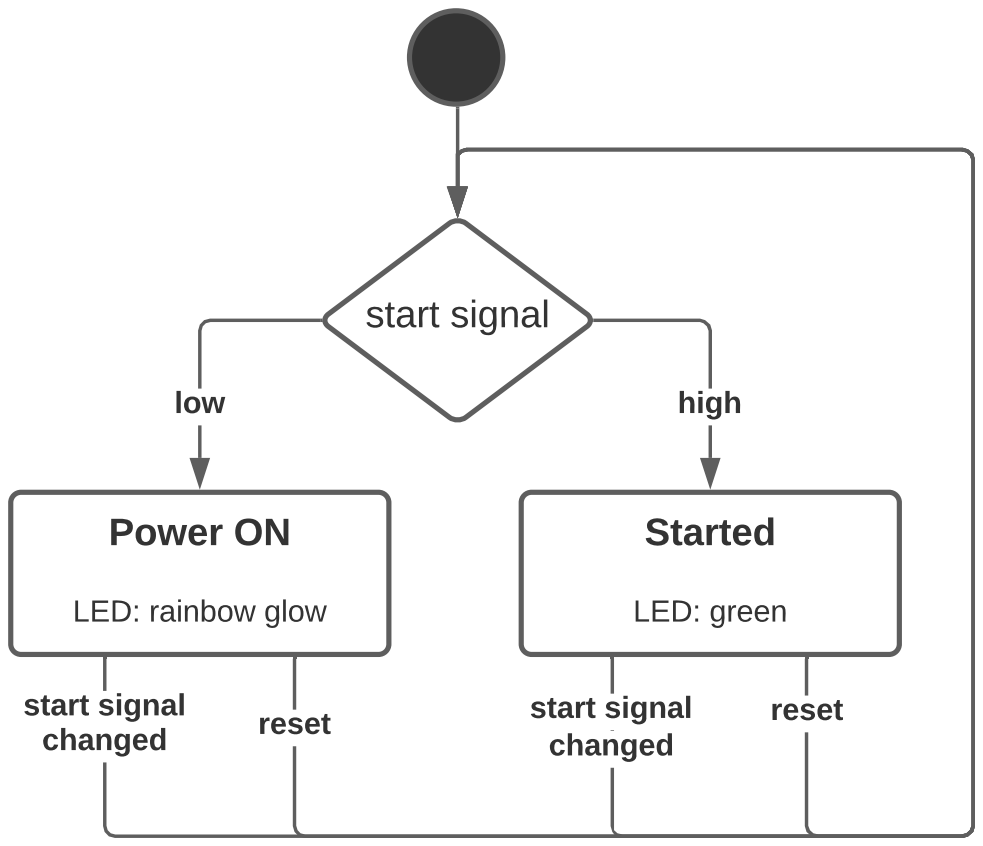
[picture p105: page 1]
Power ON; Started; LED: green; start signal; low; high; reset reset; start signal changed

LED: rainbow glow
