Eryk-Mozdzen/minisumo-scalak/docs/raport/images_program/minisumo-scalak_program_state_machine_rc5.pdf

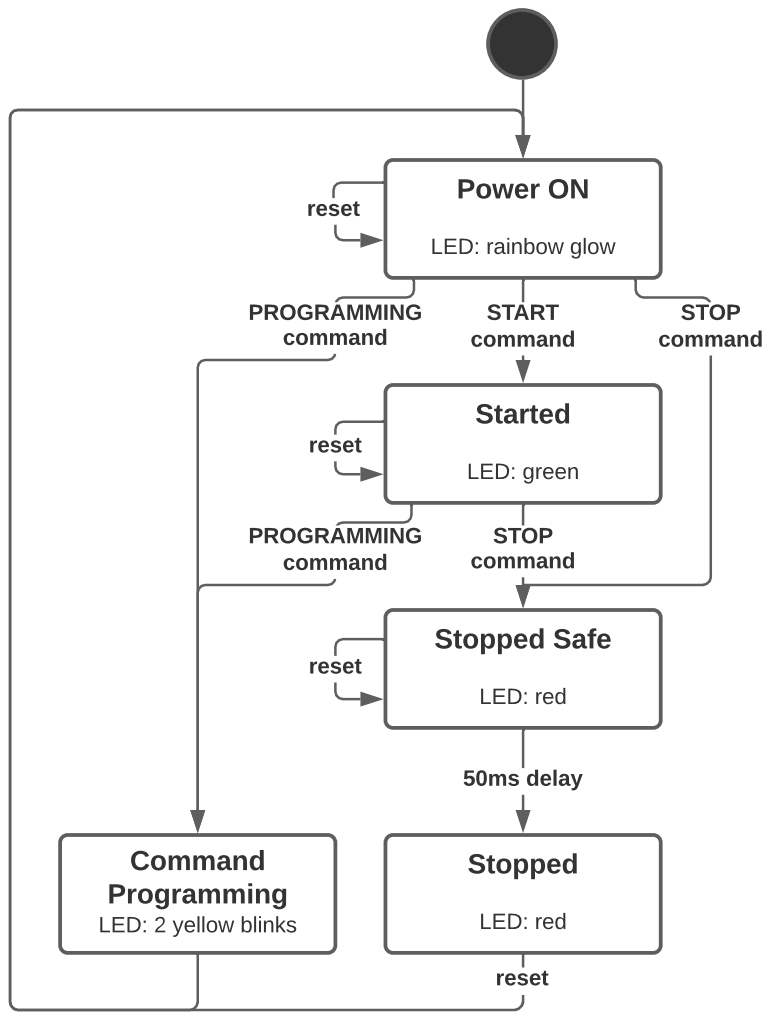
[picture p106: page 1]
Power ON; Started; LED: green; Stopped Safe; LED: red; Stopped; 50ms delay; STOP command; reset; START command; PROGRAMMING command

LED: rainbow glow

Command
Programming
LED: 2 yellow blinks
