Eryk-Mozdzen/minisumo-scalak/docs/raport/images_program/minisumo-scalak_tactics_state_machine.pdf

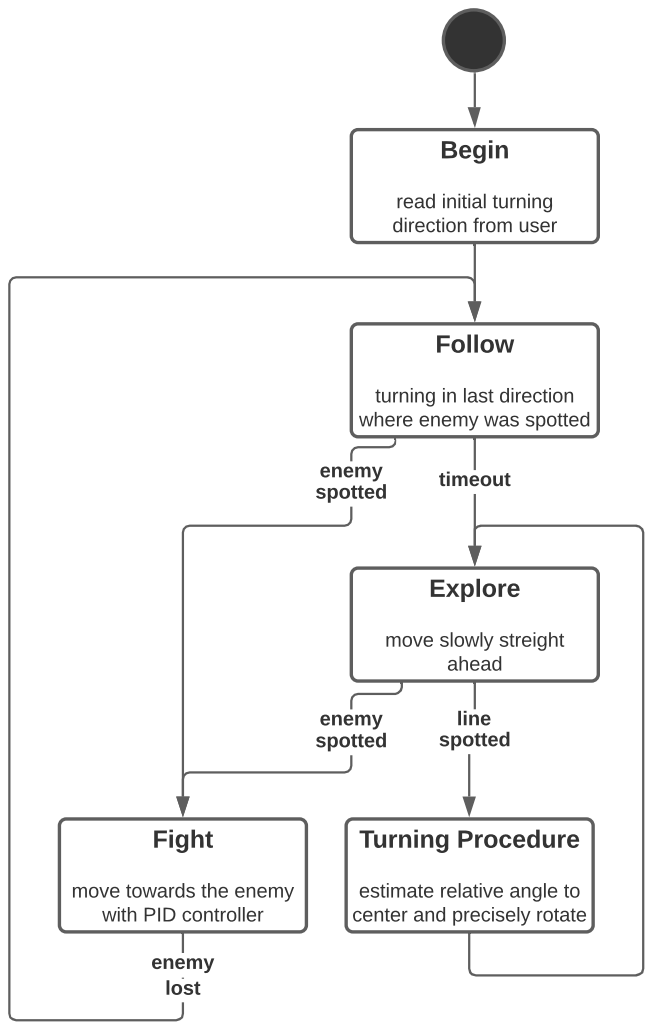
[picture p107: page 1]
Begin; Follow; Fight; Explore; enemy spotted; timeout; enemy lost; Turning Procedure; line spotted

read initial turning
direction from user

turning in last direction where enemy was spotted

move slowly streight
ahead

move towards the enemy with PID controller

estimate relative angle to
center and precisely rotate
