Eryk-Mozdzen/minisumo-scalak/hardware/scalak_main_board/scalak_main_board.kicad_pcb

## KiCad design Power.sch

Schematic: Power.sch

Parts:
C14: 220uF; CP_Radial_D8.0mm_P3.50mm; DigiKeyPN P15375CT-ND
C15: 680pF; C_0603; DigiKeyPN 478-1198-1-ND
C16, C17, C20, C21, C22, C23: 22uF; DigiKeyPN 1276-3391-1-ND
C18, C19: 0.1uF; DigiKeyPN 732-8422-1-ND
C24, C25, C26, C27: 1.0uF; C_2220; DigiKeyPN 490-3550-1-ND
C28: 22uF; C_1210; DigiKeyPN 1276-3391-1-ND
D1, D3: RFN2L4STE25; DigiKeyPN RFN2L4STE25TR-ND
D2: BAT54HT1G; D_SOD-323; DigiKeyPN BAT54HT1GOSCT-ND
J3: PJ-002A; BARREL_JACK; DigiKeyPN CP-002A-ND
J4: CONN_01X02; Pin_Header_Straight_1x02_Pitch2.54mm
L1: 100uH; Inductor_Bourns-SRN6028; DigiKeyPN SRN6028-101MCT-ND
L2, L3: 2.2uH; DigiKeyPN 587-2165-1-ND
Q1: MMBT2907ALT1G; SOT-23; DigiKeyPN MMBT2907ALT1GOSCT-ND
Q2: SiHFR220TRL; DigiKeyPN FQD12N20LTMCT-ND
R11: 0.25; R_2512; DigiKeyPN RHC2512FTR250DKR-ND
R12: 1K; R_0603
R13: 56.2K
R14, R16: 10.0K
R15: 33.2K
R17: 475K
R18: 3.09K
R19, R20: 0R0
TP6, TP7, TP8, TP9, TP10: TEST
U4: MC34063ADR; SOIC-8_3.9x4.9mm_Pitch1.27mm; DigiKeyPN 296-17765-1-ND
U5, U6: TPS562200; SOT-23-6
