Eryk-Mozdzen/minisumo-scalak/software/scalak-cmake-final/app/inc/ws2812b.h

#ifndef WS2812B_H_
#define WS2812B_H_

#include <avr/io.h>
#include <avr/interrupt.h>
#include <util/delay.h>

#define LED_STRIP_PORT	PORTB
#define LED_STRIP_DDR	DDRB
#define LED_STRIP_PIN	0

#define LED_STRIP_SIZE	1

void ws2812b_set(uint8_t, uint8_t, uint8_t);

#endif
