Eryk-Mozdzen/minisumo-scalak/software/arduino/SCALAK_V3.5_RC/fight.ino

void fight(float error, int targetPower) {
  lastEnemy = (error>0);

  float turn = pid.calculate(error,0);

  int powerL = drv8838::fix((float)(targetPower)+turn);
  int powerR = drv8838::fix((float)(targetPower)-turn);

  motors.setSpeeds(powerL,powerR);
}

int getDigit(int number, int index) {
  String str = String(number);
  if(index>=str.length()) return 0;
  char c = str[index];
  return c - '0';
}
