Eryk-Mozdzen/minisumo-scalak/(commit log)

2021-05-02 Implement uart communication and led
2021-05-02 Led bug fix and animation
    [main.c, ws2812b.c, ws2812b.h]
2021-05-12 Distance sensor
2021-07-06 Add old mechanics files
    [Bracket.SLDPRT, FelgaV1.dwg, FelgaV2.dwg, L298N.SLDPRT, MR45.x_t, MicroGearmotor_Pololu_1101.f3d, MicroGearmotor_Pololu_1101.igs, MiniSumoWheel.IGS]
2021-07-06 Add old other files
    [Cennik.xlsx, Cennik2.xlsx, ostateczneRozliczenie.xlsx, speedFactor.xlsx]
2021-07-06 uart update
2021-09-07 Add schematic
    [scalak_main_board.kicad_pcb, scalak_main_board.sch]
2021-09-18 Relocation of files
    [speedFactor.xlsx]
2021-12-02 schematic fix
    [scalak_main_board.sch]
2021-12-09 print update
2022-09-29 scheduler, state machine, led, uart and rc5
2022-09-29 line, proximity, button, switch and eeprom
2022-10-08 remove all delays and and CMake print option
2022-10-10 resolder motors PWMs and improve performance
2022-10-12 init UART only if needed
2022-10-21 remove red and green from rainbow led
2022-10-22 motors incremental limit
2022-10-29 motor change and prox sensor filtering
2022-11-13 cleaning and limit fix
    [led.c, main.c, motors.c, periph.c, periph.h, rc5.c]
2023-05-13 remove UART code whan not debug printing
